zhang1career/tars-motor-ctrl/src/platforms/stm32f030/README.md

# src/platforms/stm32f030 — STM32F030 平台层

已从 TARS 迁移的 Hall 6-step 电机控制：

| 文件 | 职责 |
|---|---|
| `hall6.c/.h` | Hall 闭环 6-step：kick、MOE 延迟释放、FocTheta 插值与一圈 ω |
| `openloop.c/.h` | 6-step / 3-step 开环 + Hall lock/kick/stall（实机诊断用） |
| `motor_pwm.c/.h` | TIM1 六路互补 PWM（20 kHz 中心对齐）、死区、MOE 控制 |
| `motor_hall.c/.h` | Hall GPIO 读取 |
| `motor_tick.c/.h` | 控制环 ISR 分发（hall6 / openloop），跑在 **TIM1 update** 上 |
| `motor_trace.c/.h` | 逐拍采样缓冲（4 ch × 256，2 KB），主机侧 `scripts/trace_dump.py` |
| `motor_adc.c/.h` | PWM 同步的三相电流 + 母线电压采样（TIM1 CH4 → TRGO → ADC → DMA） |
| `motor_angle.c/.h` | Hall 连续电角度（锚点 + per-sector 时长记忆外推） |
| `motor_cycles.c/.h` | 目标板执行时间测量，**TIM16** 自由运行计数器 |
| `motor_foc_fx.c/.h` | 定点 FOC：电流环 + 速度环。成绩见 [`docs/report/speed-loop-20260914.md`](../../../docs/report/speed-loop-20260914.md) |

正式控制方式是 **hall6 闭环**；`openloop.c` 只在实机排查时用（配合
`src/firmware/stm32f030/scripts/` 下的扫描脚本）。

默认应用参数见 `App/motor_app.c`，由实测得出：

```
phase 3, kick duty 20%, run duty 20%, direction 0（顺时针；1 为逆时针）
```

## 控制环时基

`MotorTick_Init()` 不配置 TIM3；控制环由 **TIM1 update 中断**驱动
（`MotorTick_OnTim1Update()`），与 TARS 一致。中心对齐计数在上溢和下溢各产生一次
update，因此 `motor_pwm.c` 里 `RepetitionCounter = 1`，才能得到
`MOTOR_CTRL_ISR_HZ`（20 kHz）而不是它的两倍。

**TIM3 完全空着**，留给转子角度的输入捕获（LQFP-32 上只有 PB4=CH1、PB5=CH2 能接到
`HALL_B`/`HALL_C`）。`motor_cycles.c` 的周期计数器因此用 **TIM16**，
迁移期遗留的 TIM3 中断分发已删除。

## 逐拍观测（motor_trace）

控制环唯一的细粒度观测手段。要点只有两条，都在
[`measurement-validity.md`](../../../docs/measurement-validity.md) 里有完整推导：

1. **读之前缓冲必须静止**（one-shot 自停，或对 wrap 写 `mode=0` 冻结）。
   256 拍只有 12.8 ms，而读出要约 1 s——边读边写会得到几十个片段的拼接。
2. **`ticks_since_edge` 是连贯性判据**：每个 Hall 边沿样本的值必须小于抽取比。
   它同时能把扇区长度精确重建到 50 µs，与抽取率无关。

## 相位状态编码

`motor_phase_mode_t` 三态含义与写入 TIM1 的方式：

| 状态 | CCER | CCR |
|---|---|-----|
| `MOTOR_PHASE_OFF` | 清 `CCxE` 与 `CCxNE` | 0 |
| `MOTOR_PHASE_PWM` | 置 `CCxE` 与 `CCxNE`（互补 + 死区） | 目标脉宽 |
| `MOTOR_PHASE_LOW` | 清 `CCxE`、置 `CCxNE` | **`ARR + 1`** |

`MOTOR_PHASE_LOW` 用 `ARR+1` 而不是 0：`CCxE=0, CCxNE=1` 时 OCxN 引脚直接跟随
OCxREF（不反相、不插死区），`CCR=0` 会让低边恒关、回流臂断开。

## 换向

`hall6_lookup(hall, reverse)` 与 `ol_lookup_step(hall, ccw)` 在反向时把 **PWM 相与
LOW 相互换**——同一转子位置下绕组电流反向，力矩反向而幅值不变，所以正反转效率对称。
仅靠 `direction` 位切换 hall 序列是不够的：`s_seq_ccw` 是 `s_seq_cw` 的反序，等价于
偏移 `−p`，而 `−p ≡ p (mod 6)` 恰好落在 phase 0 和 3 这两个唯一高效的偏移上。其余陷阱见
[`src/firmware/stm32f030/README.md`](../../firmware/stm32f030/README.md#已知陷阱)。

板级管脚见 `src/firmware/stm32f030/board_pins.h`。
