zhang1career/tars-motor-ctrl/docs/mainboard-spec.md

# motor-ctrl 主板设计规格（STM32F030K6 + 三相电流采样前端）

**状态**：原理图之前的**真源**。改电路先改本文，再改 KiCad 工程。

本板取代当前实测接法（MCU 由 nanoDAP 供电 + 裸分流直连 ADC），
目标是解锁 [`roadmap.md`](roadmap.md) 阶段 C（相电流采样）与阶段 E（电流环闭合）。

---

## 0. 依据（实测或数据手册，非估算）

| 项 | 值 | 来源 |
|---|---|---|
| 分流电阻 `R0` | 10 mΩ / 2512 | 半桥板网表 |
| 分流拓扑 | `Q2.S → I_SENSE → R0 → GND`（低边） | 半桥板网表 |
| `J2` 引出 | pin1 = `R0.2`(GND)，pin2 = `R0.1`(I_SENSE) | 半桥板网表 |
| 绕组电阻 | 相间 1.3 Ω → 每相 0.65 Ω | 实测 |
| 绕组电感 | 相间 874.7 µH → 每相 437.3 µH（LCR 1 kHz） | 实测 |
| 极对数 | **4**（10 s 内 311 Hall 边沿 = 51.8 电周期 ÷ 13.5 机械圈） | 实测 |
| 母线 | 12 V，实验电源限流约 1.6 A | 实测 |
| 工作点绕组电流 | 约 1.6 A @ duty 20% | 实测 |
| FOC 浮点耗时 | 15~18 k 周期（377 µs @ 48 MHz） | 阶段 B 实测 |
| UCC27211 VDD | 推荐 8 / 12 / 17 V，绝对最大 20 V | 手册 5.1 / 5.3 |
| UCC27211 `VHB−VHS` | 与 VDD 同为 −0.3 ~ 20 V 绝对最大 | 手册 5.1 |
| UCC27211 HB UVLO | 上升 6.7 V typ（5.6 min / **7.9 max**），滞环 1.1 V | 手册 5.5 |
| UCC27211 自举二极管 | **片内**，阳极 VDD、阴极 HB | 手册 6.3.4 |
| V_BOOST 实测 | **12.6 V**（12 V 经一只二极管） | 用户实测 |

### 0.1 V_BOOST 现状的正确结论

半桥板 `D1`（1N4148, `V_BOOST → HB`）与 UCC27211 **片内自举二极管并联**，
两者阳极都在 12 V 附近：

```
低占空比 (HS≈0V)    : V_C3 ≈ 12.6 − 0.8 = 11.8 V    → 落在 8~17 V 推荐窗口，安全
接近 100% duty      : 12.6 − 0.8 − 12 = −0.2 V      → D1 不导通，该路无贡献
```

**没有过压隐患。** roadmap 早期记录的「外部电荷泵 12 V → 约 20 V」与实测 12.6 V 不符，
应据实测修正；基于「20 V」推出的过压结论不成立。

但**高占空比适应性目前并不存在**——高边仍只靠片内自举，高 duty 下仍会掉进 HB UVLO。

真升压的正确形式（非旁路二极管）：

```
V_BOOST ≈ 24 V  且  HB−HS 加 15 V 齐纳钳位 + D1 后串限流电阻

低占空比   : 齐纳钳在 15 V                    (< 17 V 推荐上限, < 20 V Vgs 上限)
100% duty  : min(24 − 0.8 − 12, 15) = 11.2 V  (远高于 7.9 V 最坏 UVLO)
```

单一固定 V_BOOST 经普通二极管灌 HB **无法同时满足两端**：
`V_C3 = V_BOOST − Vf − V_HS`，而 `V_HS` 在 0 与 12 V 之间摆。
24 V 不加钳位时低占空比会把 C3 充到 23.2 V，**超过 20 V 绝对最大值，损坏驱动器**。

### 0.2 本版为何先不需要升压

低边分流采样需要低边导通窗口：

```
死区 1.5 µs + INA240 建立 ~2 µs + ADC 采样转换 ~1 µs ≈ 5 µs
→ 20 kHz (50 µs) 下 duty 上限约 90%
```

> **实测修正（2026-08-27）**：INA240 + 输出 RC 的建立时间实测**约 2 µs**，与此处假设一致
> （示波器测 `ISENSE_V` 在开关沿后到最终值一个量化码内的时间，见 roadmap 4.1）。
> 但 duty 上限没有 90% 那么高：固件为了让转换在控制 ISR 之前完成，把 ADC 序列**提前 7 µs**
> 启动，而四通道扫描本身要 6.67 µs，所以需要的半窗口是 9 µs 而非 5 µs，**上限约 67%**。
> 把 `MOTOR_ADC_LEAD_COUNTS` 减半可推到约 80%。

**比自举失效点（约 95%）更严。** 只要用低边采样，自举极限到不了。
升压真正开始重要是换成 **inline 相线采样**之后（低边采样在高调制度下失明）。
本板电荷泵输出**直接驱动 `V_BOOST`**（无跳线旁路 12 V），默认不启泵时 `V_BOOST` ≈ 10.6 V。

---

## 1. 电流采样前端

### 1.1 为什么必须差分

三块半桥板各有独立 GND 引线回主板。按 1 nH/mm 估，100 mm 引线约 100 nH；
AOD4184 关断 1.6 A 的电流变化率约 30 A/µs 量级：

```
V = L·di/dt = 100 nH × 3×10⁷ A/s ≈ 伏级瞬态
```

满量程信号仅 `±3 A × 10 mΩ = ±30 mV`。**单端测量在物理上无意义。**
1% 分立电阻搭差分放大器的共模抑制比仅 `1/(4×1%)` ≈ 28 dB，同样不够。
必须用内部修调电阻的电流检测放大器。

### 1.2 器件与工作点

| 项 | 值 | 说明 |
|---|---|---|
| 器件 | **INA240A2D**，增益 50 V/V，SOIC-8 | 内部修调，CMRR 120 dB(DC) / 90 dB(50 kHz) |
| 关键特性 | enhanced PWM rejection | 专为开关电机驱动的共模阶跃设计 |
| 共模范围 | −4 ~ +80 V | `I_SENSE` 续流时低于地；留 inline 升级余量 |
| 供电 | 3.3 V（器件范围 2.7~5.5 V） | 与 ADC 同轨 |
| 带宽 | 400 kHz | 在采样窗口内充分建立 |
| 中轨偏置 | **`REF1`(pin 7) → `GND`，`REF2`(pin 6) → `+3V3A`** | 内部二分得 1.65 V，**比例跟踪 ADC 参考**；接法理由见 §1.2.1 |
| 满量程 | ±2.9 A | `±30 mV × 50 = ±1.5 V`，受输出摆幅(约 0.02~3.1 V)限制 |
| 分辨率 | **1.61 mA/LSB** | `3.3/4096/(50×0.01)`，比裸分流 80.6 mA/LSB 好 **50 倍** |

#### 1.2.1 REF1 / REF2 的分配是布局自由度，不是电气约束

数据表 **SBOS712 §8.4.1** 原文：

> The reference inputs are connected to an internal gain network.
> **There is no operational difference between the two reference pins.**

参考分压精度的定义本身就是对称的（取绝对值）：`VOUT = |(VREF1 − VREF2)| / 2`，
指标 0.02% typ / 0.1% max，**两种接法同一条**。所以中轨 1.65 V、满量程 ±2.9 A、
1.61 mA/LSB、以及 §2 里 `ITRIP_HI/LO` 与本参考同源的比例跟踪，都与分配方向无关。

**采用 `REF1 → GND`、`REF2 → +3V3A`**，两个理由：

1. **TI 自己的应用示例就是这个方向**（§9.2.1.2 的 36 V / 4000 RPM 电机驱动用 INA240A1，
   另一处用 INA240A4），原文：「the reference point is set to midscale by splitting the
   supply with REF1 connected to ground and REF2 connected to supply」。
2. **SOIC (D) 封装上布线更短**：引脚顺序是 `4=GND, 5=VS, 6=REF2, 7=REF1, 8=OUT`，
   `REF2` 与 `VS` **相邻**，这一跳是焊盘到焊盘；`REF1` 只需一个过孔下地平面。
   反过来接则 `VS` 要越过 pin 6 的焊盘去 pin 7，而 `GND` 要挤进 VS 与 REF1 之间。
   附带好处：`VS` 的 100 nF 去耦就在 pin 5，`REF2` 直接共享那个低阻抗点，
   VS 与参考之间不再夹一段走线电感（内部分压会把二者压差的一半搬到输出偏置上）。

唯一的硬约束（数据表 Note，两种接法都满足）：
**不得把 `REF1`/`REF2` 接到低于 `GND` 或高于 `VS` 的电位。**

`check_netlist.py` 按集合判定 `{pin6, pin7} == {GND, +3V3A}`，两种接法都通过 ——
分配方向留给布局。

增益选 A2(50) 而非 A3(100)：工作点绕组电流约 1.6 A，增益 100 在 1.45 A 即削顶。

### 1.3 KiCad 符号必须自建（已完成，勿改回官方库）

**KiCad 10.0.3 自带库的 INA240 符号 D / PW 引脚定义互换**，直接使用会烧件。

| 引脚 | KiCad `INA240A2D`(SOIC 封装) | **TI 手册 D (SOIC)** | KiCad `INA240A2PW`(TSSOP 封装) | TI 手册 PW (TSSOP) |
|---|---|---|---|---|
| 1 | IN− | **NC** | NC/GND | IN− |
| 2 | GND | **IN+** | IN+ | GND |
| 3 | REF2 | **IN−** | IN− | REF2 |
| 4 | GND | **GND** | GND | NC |
| 5 | OUT | **VS** | VS | OUT |
| 6 | VS | **REF2** | REF2 | VS |
| 7 | REF1 | **REF1** | REF1 | REF1 |
| 8 | IN+ | **OUT** | OUT | IN+ |

名为 `…D`（SOIC 封装）的符号带 **TSSOP** 引脚号；名为 `…PW`（TSSOP 封装）的带 **SOIC** 引脚号。
仅 pin 7 (REF1) 碰巧一致。误用会把 3.3 V 灌到 OUT、把输出接到 VS —— **上电即毁**。

→ 已建项目本地库 **`pcb/lib/motor-ctrl.kicad_sym`**，符号名 **`INA240A2D_Fixed`**，
按 TI Table 6-1 (D 封装) 定义，已用脚本逐脚校验并通过 `kicad-cli sym upgrade` 解析。

### 1.4 每通道外围

```
J_ISx.1 (shunt 低端 = 半桥 GND) ──10Ω──┬── INA240.IN−  (pin 3)
                                       1nF (差分)
J_ISx.2 (shunt 高端 = I_SENSE)  ──10Ω──┴── INA240.IN+  (pin 2)

INA240.OUT (pin 8) ──100Ω──┬── MCU PA1/PA2/PA3
                          1nF → AGND        (fc ≈ 1.6 MHz)
```

- 输入串阻 **10 Ω 且必须匹配**：INA240 输入偏置电流经串阻产生增益误差，阻值要小。
- 差分 1 nF 仅限边沿速率，不做主滤波（主滤波靠**同步采样**，不靠 RC，避免引入延迟）。
- 输出 RC 供 ADC 采样保持电容充电，1.6 MHz corner 不引入可观延迟。
- 每片 INA240 就近 100 nF 去耦；每组 10 µF 体电容。

---

## 2. 过流保护（半桥板无 nFAULT，必须自建）

半桥板 `J3` 仅 4 线：`PWM_LIN` / `PWM_HIN` / `GND` / `V_BOOST`。
UCC27211 本身无故障输出引脚。因此 `board_pins.h` 中

```c
#define BOARD_PWM_BKIN_PIN  GPIO_PIN_6  /* PA6 TIM1_BKIN — nFAULT */
```

是 **TARS 遗留定义，物理上无处可接**。这解释了历史上启用 BKIN 导致 MOE 锁死（引脚悬空）。

STM32F030 **无片内比较器**（F031/F051 才有），故用外部窗口比较器：

```
每相 2 个比较器（正向 / 反向越限）× 3 相 = 6 个 → 2 × LM339（8 路，剩 2 路做过温，见 §6.2）
6 路开集输出线或 → nFAULT → JP2 → PA6 (TIM1_BKIN)，R16 4.7 kΩ 上拉至 +3V3
过温 2 路线或到独立的 nOTEMP → D5 单向注入 nFAULT，并直连 PA12（§6.2）
```

阈值（±2.5 A 跳闸）：`1.65 ± 2.5 × 0.01 × 50 = 1.65 ± 1.25 V` → **0.40 V / 2.90 V**。

比较逻辑（LM339 开集输出在 `V+ < V−` 时拉低）：

| 功能 | `+` 输入 | `−` 输入 | 拉低条件 |
|---|---|---|---|
| 正向越限 | `ITRIP_HI` (2.90 V) | `IOUT_x` | `IOUT_x > 2.90 V`，即电流 > +2.5 A |
| 反向越限 | `IOUT_x` | `ITRIP_LO` (0.40 V) | `IOUT_x < 0.40 V`，即电流 < −2.5 A |
| 过温 2 路 | `OTEMP1` / `OTEMP2` | `ITRIP_LO` (0.40 V) | `OTEMPn < 0.40 V`，即远端 NTC 过热（§6.2） |

**8 路全部有实际功能，没有置死单元。** 过温那两路输出接 `nOTEMP` 而非 `nFAULT`，
理由见 §6.2 —— `nFAULT` 是线或，无法区分故障源。

### 2.1 LM339 必须用 12 V 供电（不能用 3.3 V）

LM339 是 Darlington 输入级，**输入共模上限只到 `VCC − 1.5 V`**
（TI 应用手册 SNOAA35 明确建议全温区按 `VCC − 2 V` 设计）：

| 供电 | 推荐共模上限 | 能否容纳 2.90 V 阈值 |
|---|---|---|
| 3.3 V | 1.3 V | **否** |
| 5 V | 3.0 V | 勉强，无余量 |
| **12 V** | **10 V** | **可以，余量充足** |

`LMV339`（低压版）在 3.3 V 下共模上限同样不够，也不能用。
因此 **LM339 的 `V+` 接 `+12V`、`V−` 接 `GND`**；输入信号 0.15~3.15 V 落在共模范围中部，
开集输出上拉到 `+3V3`，MCU 引脚电平安全。这是开集输出的天然好处——供电轨与逻辑电平可以分开。

阈值分压串（从 `+3V3A` 取，与 INA240 的 REF **同源以保持比例跟踪**）：

```
+3V3A ──[R 4.02k]── ITRIP_HI ──[R 24.9k]── ITRIP_LO ──[R 4.02k]── GND     (1%, E96)

ITRIP_HI = 3.3 × (4.02+24.9)/32.94 = 2.897 V      分压串电流约 100 µA
ITRIP_LO = 3.3 ×  4.02/32.94       = 0.403 V
```

两个阈值节点各加 100 nF 对地去耦。LM339 输入偏置电流约 25 nA，
在 33 kΩ 分压阻抗上仅产生约 0.8 mV 误差，可忽略。

`JP2` 可断开，避免重复历史上 MOE 锁死的坑（见 §0 与 roadmap 待决项 #4）。

---

## 3. 引脚分配（与 `board_pins.h` 严格一致）

STM32F030K6Tx，LQFP-32，符号 `MCU_ST_STM32F0:STM32F030K6Tx`，
封装 `Package_QFP:LQFP-32_7x7mm_P0.8mm`。引脚表已与官方符号逐脚核对。

| 引脚 | 名称 | 网络 | 用途 |
|---|---|---|---|
| 1 | VDD | `+3V3` | 数字供电 |
| 2 | PF0 | `OSC_IN` | 8 MHz 晶振 |
| 3 | PF1 | `OSC_OUT` | 8 MHz 晶振 |
| 4 | NRST | `NRST` | SWD 复位 |
| 5 | VDDA | `+3V3A` | 模拟供电（经磁珠隔离） |
| 6 | PA0 | `NTC` | ADC_IN0，板温 |
| 7 | PA1 | `ISENSE_U` | ADC_IN1 ← INA240_U.OUT |
| 8 | PA2 | `ISENSE_V` | ADC_IN2 ← INA240_V.OUT |
| 9 | PA3 | `ISENSE_W` | ADC_IN3 ← INA240_W.OUT |
| 10 | PA4 | `VSENSE_12V` | 母线电压分压 → ADC（§9.5.1） |
| 11 | PA5 | `VSENSE_V_BOOST` | V_BOOST 监测 → ADC（§9.5.2） |
| 12 | PA6 | `nFAULT_MCU` | TIM1_BKIN ← 窗口比较器（经 `JP2` / `BKIN_EN`） |
| 13 | PA7 | `PWM_U_L` | TIM1_CH1N → 半桥1 `J3.1` (LI) |
| 14 | PB0 | `PWM_V_L` | TIM1_CH2N → 半桥2 `J3.1` (LI) |
| 15 | PB1 | `PWM_W_L` | TIM1_CH3N → 半桥3 `J3.1` (LI) |
| 16 | VSS | `GND` | |
| 17 | VDD | `+3V3` | |
| 18 | PA8 | `PWM_U_H` | TIM1_CH1 → 半桥1 `J3.2` (HI) |
| 19 | PA9 | `PWM_V_H` | TIM1_CH2 → 半桥2 `J3.2` (HI) |
| 20 | PA10 | `PWM_W_H` | TIM1_CH3 → 半桥3 `J3.2` (HI) |
| 21 | PA11 | `CP_DRIVE` | TIM1_CH4 → 电荷泵驱动（预留）+ 测试点 |
| 22 | PA12 | `nOTEMP` | 过温故障输入（EXTI12，区分过温/过流，§6.2）；`TP5`。AF `TIM1_ETR` 仍可用（开集弱上拉） |
| 23 | PA13 | `SWDIO_MCU` | 经 `R36` 100 Ω → `IR_OUT`（§9.6.3）；AF0 仍可 SWDIO |
| 24 | PA14 | `SWCLK_MCU` | 经 `R35` 100 Ω → `SWCLK`（§9.6.3）；AF1 = USART1_TX |
| 25 | PA15 | `TP_CYCLE` | GPIO 示波器时标（`motor_cycles.c`，`TP1`）；经 `R37` 100 Ω → `USART1_RX` → `J12.3`（与时标互斥）。**EVENTOUT 不使用** |
| 26 | PB3 | `HALL_A` | 黄 Ha（GPIO；无 TIM3） |
| 27 | PB4 | `HALL_B` | 绿 Hb（**TIM3_CH1** 可用于边沿捕获） |
| 28 | PB5 | `HALL_C` | 蓝 Hc（**TIM3_CH2** 可用于边沿捕获） |
| 29 | PB6 | `I2C_SCL` | I2C1 / TNB |
| 30 | PB7 | `I2C_SDA` | I2C1 / TNB |
| 31 | BOOT0 | `BOOT0` | 默认 `R17` 10 kΩ 下拉；`JP3` 可拉高进 bootloader |
| 32 | VSS | `GND` | |

### 3.1 ADC 触发源：不占引脚

F030 可用 ADC 外部触发（HAL 头文件实测）：

```
ADC1_2_EXTERNALTRIG_T1_TRGO / T1_CC4 / T2_TRGO / T3_TRGO / T15_TRGO
TIM1 MMS: TIM_TRGO_UPDATE / TIM_TRGO_OC1REF … TIM_TRGO_OC4REF
```

**采用 `TIM1_TRGO` ← update 事件。** 中心对齐 + `RCR=1` 时每 PWM 周期一次，
落在计数器峰值 —— 正是低边导通窗口中心。全程内部信号，**不占用 PA11**。

> roadmap 待决项 #2 需修正：CC4 作为 ADC 触发是**内部事件**，
> 只有 CH4 的**引脚输出**才与电荷泵抢 PA11；但 CCR4 会被电荷泵占用，
> 故改用 TRGO/update 完全避开，两边都不牺牲。

> **TIM3 与 Hall**：F030 LQFP-32 上 TIM3 只有 **PB4=CH1**、**PB5=CH2** 可用（CH3/CH4 与 PWM 低侧冲突）。
> 因此 **HALL_B→PB4、HALL_C→PB5** 可硬件捕获，**HALL_A→PB3** 仅 GPIO/EXTI；
> 三路可共用 TIM3 时基，B 通道在边沿中断里锁存 `TIM3->CNT` 即可。
>
> **TIM3 冲突提醒**：`motor_cycles.c`（阶段 A2）把 TIM3 用作 48 MHz 自由运行周期计数器。
> 若启用 Hall 捕获，须统一 TIM3 用途（同一时基 + 输入捕获，或改 cycle bench 用别的定时器）。

---

## 4. 供电

```
J1 ─[F1 2A 自恢复]─┬─[D7 SMBJ14A]─ GND        (输入保护，见 §4.1)
                   └─[D6 SS34]─→ +12V
+12V ─┬─ AMS1117-3.3 (SOT-223) → +3V3 ─┬─ 数字 (VDD)
     │                       │                                └─ 磁珠 → +3V3A (VDDA, INA240 VS, REF)
     ├─ J21（螺钉端子，三块半桥板的功率供电，与 J1 并联）
     ├─ 3 × J_CTRL.4 (V_BOOST)
     └─ 电荷泵升压级（PA11 驱动, 目标 ≈22 V）→ 直出 V_BOOST
```

### 4.1 输入保护（`F1` / `D6` / `D7`）

**关键约束：`J21` 给三块半桥板供电，母线电流全部经 `F1` 和 `D6`。**
所以这两个器件按「板上过流阈值允许的母线电流」定额，而不是按逻辑电流：

| 参考点 | 母线电流 | 来源 |
|---|---|---|
| 空载 | 0.05~0.07 A | roadmap 1.2 实测 |
| duty 20% 工作点 | 0.26 A | roadmap 3.3 实测 |
| 当前电源限流 | 1.6 A | roadmap 0.5（阶段 F 前须提高） |
| **`ITRIP` 阈值允许的上限** | **约 2.2~2.5 A** | §2 阈值 ±2.5 A/相，高占空比下母线≈相电流 |

| 器件 | 值 | 说明 |
|---|---|---|
| `F1` | 2 A 自恢复保险丝（PPTC，1206） | 标称值是**保持电流**；跳闸约 2× 保持、秒级动作。60 °C 环温降额后有效约 1.4 A。**它保护线缆与电源，挡不住瞬时短路** |
| `D6` | **SS34**（3 A / 40 V，SMA） | 串联反接保护。1 A 的 SS14 会成为链上最弱环——`F1` 要到约 4 A 才动作，永远保护不了它 |
| `D7` | **SMBJ14A**（600 W，SMB），接在 `F1` 与 `D6` **之间** | 截止 14 V / 击穿 15.6~17.2 V / 钳位 23.2 V |

**`D7` 的位置是有意的**（不在 `+12V` 上）：`F1` 在它上游 → 持续过压时保险跳闸而不是 TVS 烧毁；
它在 `D6` 上游 → 浪涌电流不必穿过 `D6`；反接时单向 TVS 正向导通 → 帮助拉跳 `F1`。

**必须认清 TVS 的能力边界**：12 V 轨的 TVS 钳位必然在 23 V 以上，而 `AMS1117` 输入绝对最大值
**15 V**、经 `J21` 供到半桥板的 `UCC27211` VDD 绝对最大值 **20 V**。所以它只吸收
**快速大能量瞬态**（带载拔电源时电机电感反冲、热插拔），**挡不住持续过压**——误插 24 V 电源
照样烧 LDO，这条链里没有器件能防。

**串联压降的代价**：`SS34` 在 1.6 A 下约 0.4 V、2.5 A 下约 0.45 V（约 1.1 W），
直接从 12 V 母线里扣掉，也让 roadmap 0.5 的电源塌陷更严重。**`D6` 需要敷铜散热**（见 §7）。
若将来母线电流超过约 2.5 A，正确升级是 **P 沟道 MOSFET 理想二极管**（2 A × 30 mΩ = 0.06 V）。

`VSENSE_12V`（`R30`）取样在 `D6` **之后**，所以固件量到的是真实的二极管后母线，
FOC 的 `vdc` 不需要补偿；电荷泵的 `D2` 同样从二极管后取电，`V_BOOST` 因此比理想值低约 0.4 V。

**母线储能 30 µF**（`C1`/`C35`/`C37` 各 10 µF，外加 `C25`/`C26`/`C27`/`C36` 各 100 nF）。
2 A 的 20 kHz 斩波下 `ΔV = I·t/C = 1 A × 25 µs / 30 µF ≈ 0.8 V` 峰峰。
**这个交流分量必须由板上电容就近吸收**——否则它会经 `F1`/`D6`/杜邦线来回跑，
把 PPTC 的热效电流抬到直流均值之上、更易误跳。`C37` 就是为此补的第三只 10 µF。
半桥板侧仍应有自己的 VIN 体电容，见 roadmap 0.5「储能加在 VIN」。

**采用单级 LDO，不用开关电源。** 负载估算：
MCU 约 15 mA + 3 × INA240 各 2.4 mA + 3 × Hall 约 10 mA + 杂项 ≈ 60~70 mA，设计上限取 100 mA。

| 方案 | 12V→3.3V @100 mA 耗散 | 噪声 | 结论 |
|---|---|---|---|
| **单 LDO (SOT-223)** | 0.61 W @70 mA / 0.87 W @100 mA；SOT-223 约 60 °C/W → 升温约 37~52 °C | **无开关噪声** | **采用** |
| buck 5V + LDO 3.3V | LDO 仅 0.17 W | 开关节点靠近 30 mV 模拟信号 | 负载这么小时不值得 |
| 单 buck 直出 3.3V | 最低 | 开关噪声直接进模拟轨 | 否 |

在 70 mA 这个量级，LDO 的热损耗完全可以接受（SOT-223 配敷铜，结温约 62~77 °C），
而**彻底没有开关节点**对 ±30 mV 的分流信号是实打实的好处。
`AMS1117-3.3` 输入上限 15 V，12 V 输入有余量。LDO 布局上远离三片 INA240。

若将来负载显著增加（加显示、更多传感器）再改两级，本板不预留 buck 位置。

**板载 3.3 V 取代 nanoDAP 供电**：roadmap 已把「探头供电」列为误判来源
（探头掉线表现为「母线 0.000 A 且完全无 PWM」，极易误判成硬件坏）。

---

## 5. 连接器（与半桥板一一对应，便于普通杜邦线）

| 编号 | 型式 | 引脚 | 对接 |
|---|---|---|---|
| `J_CTRL1..3` | 1x04 P2.54 | 1=`PWM_x_L`, 2=`PWM_x_H`, 3=`GND`, 4=`V_BOOST` | 半桥板 `J3` |
| `J_IS1..3` | 1x02 P2.54 | 1=shunt 低端, 2=shunt 高端 | 半桥板 `J2` |
| `J_HALL` | 1x05 P2.54 | **1=`GND`, 2=`+3V3`**, 3=`HALL_A`, 4=`HALL_B`, 5=`HALL_C` | 电机 Hall（`J8`） |
| `J_DEBUG` | 1x05 P2.54 | `GND`, `IR_OUT`, `SWCLK`, `+3V3`, `NRST` | 调试/红外（`J9`；无 SWDIO 引出） |
| `J_IR` | 1x02 P2.54 | `GND`, `IR_OUT` | 红外输出（`J11`） |
| `J_UART` | 1x03 P2.54 插座 | `GND`, `SWCLK`(=PA14 TX), `USART1_RX`(=PA15) | USB-TTL / bootloader（`J12`，兼作 SWCLK 探针） |
| `J14` / `J15` | 1x02 P2.54 | `OTEMP1` / `OTEMP2`, `GND` | 外接 10 kΩ NTC（§6.2） |
| `J_I2C` | 1x04 P2.54 | `+3V3`, `SDA`, `SCL`, `GND` | 主机 / TNB |
| `J_PWR` | 螺钉端子 1x02 | `12V`, `GND` | 实验电源（`J1`，经 `F1`/`D6` 进板，§4.1） |
| `J21` | 螺钉端子 1x02（Phoenix MKDS-1,5-2-5.08） | 1=`GND`, 2=`+12V` | **三块半桥板的功率供电**，与 `J1` 并联（§5.1） |

**所有排针的 pin 1 都是 `GND`**（`J1`/`J8`/`J9`/`J10`/`J11`/`J12`/`J21`），保持这个约定。

### 5.1 `J21`：三块半桥板共用一个功率端子

用螺钉端子而不是 2.54 mm 针座：`ITRIP` 阈值允许的母线电流约 2.5 A，超出针座的合理范围；
Phoenix MKDS-1,5 按 1.5 mm² 端子额定约 13.5 A，余量充足。三块半桥板在**板外并接**到这一个端子。

两个由此产生的注意点：

1. **三块板的功率地在板外汇合**，不再各自有独立回流脚。这对分流采样无影响——
   INA240 是差分测量（§1.1），板间共模差由它的 120 dB / 90 dB@50 kHz 抑制掉。
   但共用回流线上跑的是三相斩波电流的**和**，稳态基波相互抵消而开关分量不抵消，
   所以这根线要短、要粗，最好与 `+12V` 那根**紧贴走**以减小回路面积。
2. **`H1`/`H2`/`H3` 是接地的 M3 安装孔**（`MountingHole_Pad`，焊盘接 `GND`）。
   若机箱另有接地点，注意不要形成大面积地环。

**`J_IS1..3` 的两根线在 PCB 上与电缆里都必须作为紧耦合差分对处理**——
共模是主误差源（见 1.1）。电缆建议双绞。

**Hall 供电为 `+3V3`，不设跳线。** `board_pins.h` 标注 3.3 V，且实测已证实
（hall6 闭环正常换相，10 s 读到 311 个 Hall 边沿），因此无需保留 5 V 选项与选择跳线。
Hall 信号线上拉同样接 `+3V3`（见 §6），保证 MCU 输入不超过 3.3 V。

---

## 6. 其余外围

| 项 | 值 | 说明 |
|---|---|---|
| 晶振 | 8 MHz 两引脚 + 2 × 10 pF 负载电容 + `R29` 1 kΩ 串阻 | `main.c` 强制 HSE，失败即 `Error_Handler()`。**必装** |
| Hall 上拉 | 4.7 kΩ → **`+3V3`**，串 1 kΩ + 1 nF 对地 | 开集输出需上拉；`fc ≈ 160 kHz` |
| BOOT0 | `R1` 10 kΩ 下拉 + `JP3`（`+3V3`↔`BOOT0`） | 见 §9.6.2；探测点用 `JP3` pin 2 |
| NRST | 100 nF 对地 + **10 kΩ 上拉**（`R23`） | connect-under-reset |
| SWCLK | **100 Ω 串阻**（`R35`：`U1.24` ↔ `SWCLK`，靠近 MCU） | PA14/UART TX 与调试器对顶（§9.6.3） |
| IR 输出 | **100 Ω 串阻**（`R36`：`U1.23` ↔ `IR_OUT`，靠近 MCU） | PA13 红外推挽与探头对顶（§9.6.3） |
| I2C | **10 kΩ 上拉**（`R26`/`R27` → `+3V3`） | TNB 主机 |
| 指示 | `D1`+`R24`（12 V 电源）、`D4`+`R34`（3.3 V 状态） | 目视确认上电 |
| 去耦 | 每 VDD 100 nF；VDDA 1 µF + 100 nF | |
| NTC | 10 kΩ NTC + 10 kΩ 分压 + `C33` 100 nF → PA0 | 板温遥测；功率级过温靠 §6.2 |
| I2C ESD | `D8` PRTR5V0U2X（1=GND, 2=SDA, 3=SCL, 4=`+3V3`） | 1 pF/线，相对 400 pF 总线预算可忽略 |
| +3V3 ESD | `D9` SMAJ5.0A | **仅 ESD**：钳位 9.2 V 远高于 STM32 的 4.0 V 绝对最大值 |

Hall 边沿率上限核算：3000 rpm 机械 = 50 机械转/s × **4 极对** × 6 边沿 = **1.2 kHz**，
160 kHz 滤波余量充足。

### 6.1 调试测试点（`TP1`…`TP23`，无 `TP10`）

手工原理图在关键节点加了测试点，便于 bench 探针而无需飞线 MCU 引脚。

| 编号 | 网络 | 用途 |
|---|---|---|
| `TP1` | `TP_CYCLE` | PA15 示波器时标 / bootloader RX |
| `TP2` | `CP_DRIVE` | PA11 电荷泵驱动 |
| `TP3` | `VSENSE_12V` | PA4 母线分压 |
| `TP4` | `VSENSE_V_BOOST` | PA5 V_BOOST 分压 |
| `TP5` | `nOTEMP` | PA12 过温故障线（§6.2） |
| `TP6` | 电荷泵推挽基极 | Q1/Q2/Q3 基极节点 |
| `TP7` | 电荷泵开关节点 | `CP_SW`（Q1.E / Q2.E） |
| `TP9` | 电荷泵泵电容节点 | D2/D3/C32 交汇 |
| `TP11`…`TP13` | `ISENSE_U/V/W` | INA240 输出经 RC 后 → MCU ADC |
| `TP14`…`TP16` | `IOUT_U/V/W` | INA240 原始输出（比较器输入） |
| `TP17` / `TP18` | `ITRIP_HI` / `ITRIP_LO` | 过流阈值 |
| `TP19` | `nFAULT_MCU` | BKIN 路径（经 `JP2`） |
| `TP20` | `NTC` | 板温分压 |
| `TP21`…`TP23` | `HALL_A/B/C` | Hall 滤波后 MCU 输入 |
| `TP24` / `TP25` | `OTEMP1` / `OTEMP2` | 远端 NTC 分压节点，用于判断是哪一路过热 |

晶振走线：`Y1` 为两引脚 HC-18；`C1` 接 `OSC_IN`，`C2` 接晶振对端并经 `R29` 1 kΩ 至 `OSC_OUT`。

### 6.2 远端 NTC 过温保护（LM339 余下 2 路）

板载 `RT1`（PA0）量的是**主板温度**，主要被 LDO 那 0.6~0.9 W 主导，**看不到半桥板 MOSFET 与电机**——
而 roadmap 记录的过热事故正是「3 号板过热」，阶段 G 还有永磁体不可逆去磁风险。
ADC 通道已用尽（MCU 自带 die 温度与 VREFINT 只覆盖板级），**比较器不需要 ADC 通道**，正好补这个盲区。

```
+3V3A ──[R38 10k]──┬── OTEMP1 ──┬── J14.1   (J14.2 = GND，外接 10k NTC)
                   │            ├──[C30 100nF]── GND
                   │            ├──[R39 100k]── nOTEMP      (迟滞)
                   │            └── U7C.11 (+)
U7C: − = ITRIP_LO   out = nOTEMP          (OTEMP2 / R41 / C31 / R42 / U7D 同构)

+3V3A ──[R40 4.7k]── nOTEMP ──┬── U1.22 (PA12, EXTI12) + TP5
                              └── D5 (BAT54) K ── A ── nFAULT
```

**门限白蹭现成的 `ITRIP_LO`。** 分压方向是「上拉 + NTC 对地」，温度升高 → 节点电压**下降**；
分压串与 `ITRIP_HI/LO` 同取自 `+3V3A`，保持比例跟踪。

**选用 NTC：10 kΩ @25 °C，B = 3435。**
**两路门限不同** —— 每路有自己的上拉与迟滞电阻，只有阈值节点 `ITRIP_LO` 共享，
所以上拉阻值就是该路的门限旋钮：

| 通道 | 探头位置 | 上拉 / 迟滞 | 跳闸 | 恢复 | 迟滞 | 依据 |
|---|---|---|---|---|---|---|
| `OTEMP1` | **半桥板 MOSFET** | `R38` 10 k / `R39` 100 k | **90 °C** | 86 °C | 3.9 °C | AOD4184 `Tj,max` 150 °C，余量充足 |
| `OTEMP2` | **电机磁钢 / 绕组** | `R41` 13 k / `R42` 150 k | **80 °C** | 77 °C | 3.2 °C | N35 类烧结钕铁硼工作上限约 80 °C，见 roadmap 阶段 G 去磁风险 |

（跳闸门限对应的 NTC 阻值：`OTEMP1` 1.26 kΩ、`OTEMP2` 1.66 kΩ；恢复门限 1.40 / 1.82 kΩ。）

门限数字用单 B 值模型算，在 90 °C 处与厂家 R–T 表可能差 2~3 °C；叠加 NTC 与电阻的
1% 容差，实际按 **±5 °C** 看待，需要精确值时以厂家 R–T 表复核。

**`D5` 必须是肖特基，且方向是「A 在 `nFAULT`、K 在 `nOTEMP`」**，这样耦合是单向的：

| 事件 | `nOTEMP` | `nFAULT` | PA12 | 结果 |
|---|---|---|---|---|
| 过温 | U7C/D 拉低 | 经 `D5` 钳低 | **低** | BKIN 跳闸 + 固件知道是过温 |
| 过流 | 高（`D5` 反偏） | U6/U7 拉低 | **高** | BKIN 跳闸 + 固件知道**不是**过温 |

若用硅二极管，过温时 `nFAULT` 低电平 = `V_OL(LM339 最坏 400 mV) + Vf(0.55 V) ≈ 0.95 V`，
逼近 `V_IL ≈ 0.3·VDD ≈ 0.99 V`；BAT54 的 `Vf ≤ 0.32 V` 给出约 0.72 V，余量 270 mV。

三条必须记住的性质：

1. **迟滞电阻只能接 `nOTEMP`，绝不能接 `nFAULT`** —— 否则任一路过流都会去搬动过温门限。
2. **两路迟滞共用 `nOTEMP`**，所以 2 号探头跳闸会把 `OTEMP1` 也拽低约 40 mV（≈3 °C）。
   因为两路本来汇成同一个标志、BKIN 又是锁存的，这个交叉耦合无实际后果。
3. **`J14`/`J15` 空置时 `OTEMPn` = 3.3 V = 不跳闸**。失效方向是「不误跳」，
   探头脱落不会被察觉；这是有意的取舍。
4. 过温这一路的「停用开关」就是**把 NTC 拔掉**，所以不需要跳线；整条 `nFAULT → PA6`
   仍可由 `JP2` 断开。

---

## 7. 布局要点（PCB 阶段验收项）

1. **分流 Kelvin 对**：`J_ISx` 两脚到 INA240 输入走紧耦合差分对、等长，
   中间不跨地平面分割，远离 PWM 走线与功率回流路径。
2. **地分区**：`AGND`（INA240 + VDDA + REF 分压）与 `GND`（数字 + 连接器）
   单点连接，连接点置于 MCU VSS/VDDA 附近。
3. **LDO 及其散热敷铜**远离三片 INA240（0.61 W 的热源，避免热梯度）。
   **`D6` 同样需要敷铜**（2.5 A 下约 1.1 W），并与模拟区分开。
4. **PWM 六路**尽量等长、同臂 H/L 相邻成对，远离模拟区。
5. INA240 去耦电容紧贴 VS 引脚。
6. 电荷泵升压级（预留）与模拟区物理分离。

---

## 8. 与固件的耦合点

| 固件位置 | 依赖本规格 |
|---|---|
| `board_pins.h` | 引脚表须与 §3 一致；`BOARD_PWM_BKIN_PIN` 注释需从「nFAULT」改为「窗口比较器」 |
| `motor_cycles.c` | 用 `BOARD_TP_CYCLE_PIN` = PA15（网表名 `TP_CYCLE`）做示波器交叉验证 → `TP1`。**不使用 EVENTOUT AF**，纯 GPIO 推挽 |
| 阶段 C ADC | 触发源 `TIM1_TRGO` ← update（§3.1）；采样窗口在低边导通期（§0.2） |
| 阶段 C 标定 | 零电流上电校准（INA240 输出应为 1.65 V）；交叉验证用 `I_bus = D_eff²·V/R` |
| 阶段 E 保护 | `JP2` 接通后才启用 TIM1 BKIN；PA12 (`nOTEMP`) 配成 EXTI12 输入以区分过温/过流（§6.2） |

---

## 9. 待确认

| # | 项 | 影响 | 状态 |
|---|---|---|---|
| 1 | 12.6 V 测于二极管**前**还是**后** | 仅影响 §0.1 记录的余量数字，不影响电路 | 未确认 |
| 2 | 电机 Hall 供电 3.3 V 或 5 V | 实测已证实 3.3 V 可用，取消 5 V 选项与跳线（§5） | **已解决** |
| 3 | 是否装配 12 V→24 V 升压级 | 决定升压级是装配还是仅留位置；见 §0.2 | 默认仅留位置 |

**板载 3-BJT 电荷泵**（§9.5.3）。输出直接接到 `V_BOOST` → 三块半桥 `J_CTRL.4`。
**不设 `JP1` 切换**——启泵前须在半桥板加 HB–HS 钳位（§9.5.4），否则低占空比会过压。

---

## 9.5 板载检测与电荷泵

**以 KiCad 手工原理图 `motor-ctrl-mainboard.kicad_sch` 为布局真源**；
`gen_schematic.py` 维护同等网表（标签化、可机器校验），二者须同步。
`add_sense_and_pump.py` 已废弃（TC4427 旧方案）。

### 9.5.1 PA4 母线电压检测（必需，此前是缺口）

`foc_step_stm32(ia, ib, ic, **vdc**, ...)` 把母线电压当**必需输入**，
而原设计没有任何测量手段。FOC 用 `vdc` 归一化 SVPWM 占空比，
写死 12 V 会在电源塌陷（撞 1.6 A 限流）时让输出占空比成比例出错。

```
+24V ──[R30 82k]──┬── VSENSE_24V (PA4)
                  ├──[R31 10k]── GND
                  └──[C28 100nF]── GND
```

分压比 9.2：24 V → 2.609 V，满量程约 30 V，分压串耗流约 235 µA。
固件侧网络名仍对应 ADC 通道 `ADC_IN4`。

### 9.5.2 PA5 V_BOOST 监测

```
V_BOOST ──[R32 18k]──┬── VSENSE_V_BOOST (PA5)
                     ├──[R33 1k]── GND
                     └──[C29 100nF]── GND
```

分压比 19：32 V → 1.684 V，满量程约 62.7 V。电荷泵闭环目标 **32 V**（§9.5.5）。
固件侧对应 `ADC_IN5`。作用是让固件能**直接看到自举/电荷泵塌陷**，
而不是靠电机停转反推——正是 §0.1 讨论的那个高占空比失效模式。

### 9.5.3 板载电荷泵（3-BJT + PA11，无 555 / 无 TC4427）

沿用 `charge-pump/pcb` 的**二极管倍压 + 互补推挽**（`Q1`/`Q2`），振荡源改为 `PA11 = TIM1_CH4`。
PA11 **不能直接驱动** `Q1`/`Q2` 基极（ngspice：3.3 V 直驱 `CP_SW` 仅 2.21 V 峰峰值，
`V_BOOST` 停在 12.2 V 完全不倍压）。

增加 **`Q3` 电平移位 + `R28` 上拉**（`reports/cp_bjt_compare.cir` 方案 D）：

```
PA11 ──[R25 2.2k]── Q3.B ── Q3.E=GND ── Q3.C=CP_BASE ──[R28 470R]── +12V
CP_BASE ── Q1.B / Q2.B ；  Q1(NPN) C=+12V ；  Q2(PNP) C=GND ；  Q1.E=Q2.E=CP_SW
CP_SW ──[C32 47nF]── CP_PUMP ── D2(+12V充电) / D3(→V_BOOST)
V_BOOST ── C34 100nF ∥ C38 10uF ── GND ；  +12V ── C35/C36 去耦
```

| 器件 | 值 |
|---|---|
| `R25` | 2.2 kΩ（PA11 → Q3 基极） |
| `R28` | 470 Ω（+12V 上拉）——**非关键值，220 Ω~2.2 kΩ 等效，见下** |
| `C32` | **470 nF / 0805** ——决定输出阻抗的唯一参数，见下 |
| `R43`/`R44` | 0 Ω，Q1/Q2 各一只独立 base stopper（见下） |
| `Q1`/`Q3` | SS8050；`Q2` SS8550 |

输出**直接驱动 `V_BOOST`**（无 `JP1`、无 TC4427）。停泵时 `V_BOOST` ≈ 10.6 V。
**`Q1`/`Q2` 是互补射极跟随器**（B 经各自 stopper 接 `CP_BASE`、E 共接 `CP_SW`），不是图腾柱：
`V_BE(Q1) = CP_BASE − CP_SW` 与 `V_BE(Q2)` 恒为等值反号，结构上排除直通，
所以 `CP_BASE` 到两管基极**不需要串限流电阻**（`R28` 本身就是上升沿的限流元件）。

`R43`/`R44` 是防**射极跟随器带容性负载寄生振荡**的 base stopper，装 0 Ω；
若实测 `CP_SW` 有高频振铃再换约 22 Ω。**必须每管一只独立**——
在公共节点串一只不是 stopper，只是把 `R28` 变大。

**与 TC4427 取舍：** 选 3-BJT 因成本。固件用 PA11 PWM + PA5 监测闭环调节。

#### 电荷泵实测（ngspice，`reports/cp_r28_sweep.cir` / `cp_load_sweep.cir` / `cp_c32_sweep.cir`）

> 早期 `cp_bjt_compare.cir` 把 `Q1`/`Q2` 的 `nb`/`ne` 写反（ngspice 是 `Q nc nb ne`），
> 导致 `CP_SW` 多数时段悬空；且 10 µF 储能配 47 kΩ 是 470 ms 时间常数，15 ms 根本没到稳态。
> 两处都已修正，下表是修正后的结果。**旧结论「470 Ω 上拉使 `CP_SW` ≈ 11.6 V p-p」作废。**

`R28` 扫描（负载 1 mA）——**摆幅与输出电压几乎不随 `R28` 变化**，只影响峰值电流：

| `R28` | `CP_SW` p-p | `V_BOOST` | `C32` 峰值电流 |
|---|---|---|---|
| 220 Ω | 10.78 V | 20.63 V | 94 mA |
| **470 Ω（现值）** | 10.82 V | 20.68 V | 65 mA |
| 1 kΩ | 10.82 V | 20.71 V | 44 mA |
| 2.2 kΩ | 10.80 V | 20.72 V | 28 mA |

**倍压器的输出阻抗 ≈ `1/(C32·f)` = `1/(47n × 20k)` = 1.05 kΩ**，这才是决定性参数：

| 负载 | `V_BOOST` | 纹波 |
|---|---|---|
| 0.1 mA（近空载） | **21.67 V** | 11 mV |
| 1 mA | 20.68 V | 44 mV |
| 3 mA | 18.78 V | 148 mV |
| 10 mA | **11.32 V**（完全塌陷，不再倍压） | 488 mV |

`C32` 扫描（负载 3 mA）——加大 `C32` 同时改善输出电压**并降低**峰值电流
（同样的每周期电荷量摊在更大的电容上，`ΔV` 更小、导通窗口更长）：

| `C32` | `V_BOOST` @3 mA | 峰值电流 |
|---|---|---|
| 47 nF（原值） | 18.78 V | 232 mA |
| 100 nF | 20.12 V | 140 mA |
| **220 nF** | **20.81 V** | **70 mA** |
| 470 nF | 21.06 V | 35 mA |

→ **已采用 470 nF / 0805**（选 50 V 以限制直流偏压降容；`CP_SW`–`CP_PUMP` 间直流偏压约 11 V）。
注意这会让 §9.5.4 的低占空比过压更确定，**所以必须先有半桥钳位**。

### 9.5.4 关键约束：启用电荷泵前必须给半桥板加钳位

倍压输出 `≈ 2×12 − 2×Vf`，ngspice 实测近空载 **21.7 V**（与手算 22 V 一致）。
代入 §0.1 的关系 `V_C3 = V_BOOST − Vf − V_HS`：

| 工况 | `V_C3` = `VHB−VHS` | 判定 |
|---|---|---|
| 低占空比 (`V_HS≈0`) | 21.7 − 0.8 = **20.9 V** | **超过 20 V 绝对最大值** |
| 接近 100% duty (`V_HS≈12`) | 21.7 − 0.8 − 12 = 8.9 V | 高于 7.9 V 最坏 UVLO ✓ |

也就是说约 22 V 能解决高占空比，但会在**正常低占空比工作点损坏驱动器**。
（这个结论在修正后的仿真下依然成立，见 §9.5.3 的实测表。）

根因是 §0.1 已给出的：`V_HS` 摆幅 12 V，而 `V_C3` 的允许窗口（UVLO 8 V ~ 推荐上限 17 V）
只有 9 V 宽，**没有任何固定 V_BOOST 能同时满足两端**。

→ **未加半桥钳位前不要启泵。** 输出直接驱动 `V_BOOST`（无 `JP1` 旁路 12 V）。
要在每块半桥板的 `C3`（HB–HS）两端加 **15 V 齐纳钳位** + `D1` 后串限流电阻。
加了钳位后：低占空比钳在 15 V ✓，100% duty 得 `min(21.7−0.8−12, 15) = 8.9 V` ✓。
高占空比余量偏薄（最坏 UVLO 7.9 V），这也是把 `C32` 加大到 220 nF 的另一个理由：
高 duty 时 `V_BOOST` 要顶住三路自举的补充电流，输出阻抗越低越好（§9.5.3 负载表）。

`D4` 在板上是 **3.3 V 状态 LED**（`R34` 限流），不是 V_BOOST 齐纳。
V_BOOST 过压保护仍须靠半桥板 HB–HS 钳位，不能靠主板齐纳。

### 9.5.5 固件优先级：电荷泵先于半桥供电

**电荷泵升压的优先级高于半桥输出使能。** 高边 MOSFET 要靠 `V_BOOST` / 自举电容上的
足够电压才能完全导通；`V_BOOST` 塌陷时，即使 TIM1 相位 PWM 已经输出，半桥也不能
当作“已供电”。

| 顺序 | 要求 |
|---|---|
| 1 | 上电后 `Boost_Poll()` 必须持续运行（主循环里**先于** `TnbMotor_Task` / 六步 / FOC），按 PA5 反馈调节 PA11 电荷泵 |
| 2 | **禁止**用 PA4 `VSENSE_12V` 作电荷泵反馈或 `Boost_Ready` 判据（该脚是 +12 V 分压，与 `V_BOOST` 无关） |
| 3 | **禁止**为了过软件门闩而长期把 TIM1_CH4（电荷泵开关）固定在关断；`Boost_Ready()==0` 时应加 duty、不应静默停泵 |
| 4 | `MotorPwm_ArmOutputs()`、MOE、六步换相**仅允许**在 `Boost_Ready()==1`（PA5 显示 `V_BOOST` 已达就绪窗口）且 nFAULT 未拉低之后 |
| 5 | 与 §9.5.4 硬件前提独立：未装半桥 HB–HS 钳位时，目标电压与启泵策略仍受该节约束；**一旦按实验要求启泵，运行循环里不得再擅自停泵** |

固件真源：`src/platforms/stm32f030/boost.c` / `boost.h`；状态字 `vboost=` 来自 PA5，
`vbus=`（若上报 PA4）表示 +12 V 监测，**不是** 24 V 母线。

---

## 9.6 PA14 复用 SWCLK / USART1_TX（已采纳）

### 9.6.1 决定与依据

`PA14 AF0 = SWCLK`，`AF1 = USART1_TX`（数据手册脚注 (2)：x4/x6 器件可用，K6 属于 x6）。
STM32 的 AF 多路器**同一时刻只能选一个功能**，两者互斥。

采纳复用，理由：I2C（PB6/PB7）是运行期控制接口不能占用；
而 SWCLK 只在调试期使用、串口日志只在发布后运行期使用，**时间上不重叠**。

关键支撑事实（数据手册 §3.5）：

> The boot loader is located in System Memory. It is used to reprogram the Flash
> memory by using USART on pins **PA14/PA15** or PA9/PA10.

**内置系统 bootloader 用的正是 PA14/PA15。** 所以发布固件占用 PA14 做 TX 之后，
仍可通过**同一条串口**、靠 BOOT0 拉高进 bootloader 重新烧录——
「失去 SWD」不再是变砖，而是换一条正常的烧录路径。
`PA15 AF1 = USART1_RX`，需要 RX 时可一并使用（发布版不跑 `motor_cycles.c` 的示波器测试点）。

### 9.6.2 前提：BOOT0 必须可设置（已添加）

原设计 BOOT0 只有 `R17` 10k 下拉、未引出任何位置，无法进 bootloader。已追加：

| 器件 | 连接 | 说明 |
|---|---|---|
| `JP3` Jumper_2_Open | `+3V3` ↔ `BOOT0` | 闭合 = 复位时 BOOT0 高 = 进 bootloader；断开时 `R17` 保持低（闭合时跳线胜出，耗流 330 µA） |
（BOOT0 的探测点就用 `JP3` pin 2，不另设测试点。）

两条恢复路径由此都成立：

| 路径 | 前提 | 现状 |
|---|---|---|
| SWD connect-under-reset | NRST 可控 + 固件不过早切 AF | `NRST → J9.5` 已引出，`openocd.cfg` 为 `srst_only` ✓ |
| 系统 bootloader（PA14/PA15 串口） | BOOT0 可拉高 | **`JP3` 已添加** ✓ |

### 9.6.3 调试口串阻（`R35`/`R36`，各 100 Ω）

PA14 复用 SWCLK / USART1_TX；PA13 复用 SWDIO / **红外输出**（`IR_OUT`）。
发布固件可能在两脚上推挽驱动，而调试器或红外接收头仍连着排针 → 须限流。

```
U1.24 (PA14) ── R35 100R ── SWCLK ── J9.3 / J12.2     （网表标签亦作 USART1_TX 注释）
U1.23 (PA13) ── R36 100R ── IR_OUT ── J9.2 / J11.2
U1.25 (PA15) ── TP1 (TP_CYCLE)                        （bootloader 时作 USART1_RX）
```

对顶电流约 **3.3 V / 100 Ω ≈ 33 mA**。`J9` **不引出 SWDIO**——全功能 SWD 需飞线到
MCU 侧测试点，或依赖 connect-under-reset + bootloader（§9.6.2）。

### 9.6.4 固件侧约束

1. **切 AF 的时机不能早。** connect-under-reset 需要探头有一个窗口。
   建议做成**编译期选择**：调试版保留 SWCLK，发布版才切 USART1_TX。
2. 若发布版也想保留可调试性，可用跳线/strap 或延时若干秒后再切。
3. **代价要认下来**：发布版单板无法用 SWD 做事后分析——
   例如读不出阶段 A1 的 trace 缓冲。实验板可接受，量产件需权衡。

原理图**布局以 KiCad 手工排版为准**；连接关系由 `pcb/tools/gen_schematic.py`
中的网表表维护，并与 `motor-ctrl-mainboard.kicad_sch` **保持同步**。
改连接：先改手工图或 `gen_schematic.py`（二者一致），再跑 `check_netlist.py`。
**勿盲目 `gen_schematic.py` 覆盖**已排版原理图——生成器只保证网表，不保留坐标。

```
pcb/
├── lib/motor-ctrl.kicad_sym      # 项目符号库（修正引脚的 INA240A2D_Fixed）
├── tools/
│   ├── ksym.py                   # 符号库读取 + extends 展平
│   ├── ksch.py                   # 原理图发射器（线头 + 网络标签）
│   ├── gen_schematic.py          # 网表真源 → 原理图
│   └── check_netlist.py          # 导出网表 vs 规格 / 数据手册 逐脚核验
└── mainboard/
    ├── motor-ctrl-mainboard.kicad_sch
    ├── motor-ctrl-mainboard.kicad_pro
    ├── sym-lib-table             # 注册项目库
    ├── net.net / erc.rpt / mainboard.pdf
```

### 10.1 重新生成与验证

```bash
KCLI=/Applications/KiCad/KiCad.app/Contents/MacOS/kicad-cli
cd pcb/tools && python3 gen_schematic.py
cd ../mainboard
$KCLI sch erc --severity-all -o erc.rpt motor-ctrl-mainboard.kicad_sch
$KCLI sch export netlist --format kicadsexpr -o net.net motor-ctrl-mainboard.kicad_sch
cd ../tools && python3 check_netlist.py       # 退出码非 0 即视为不可投板
```

当前状态（手工原理图）：**148 个器件**；网表校验见 `check_netlist.py`。
生成器与手工图**器件、参数逐项一致**（146 : 146），两边 `check_netlist.py` 均 0 失败。
生成器网表应与手工图一致；重新生成仅用于核对或空白起步，会丢失排版。

### 10.2 为什么用「线头 + 网络标签」风格

每个引脚接一段短线加一个网络标签，而不是画点对点连线。图不好看，但

- 连接关系由**标签**承载，与摆放位置无关——在 Eeschema 里重新排版**不会破坏网表**；
- 网表就是生成脚本里那张表所写的内容，可被 `check_netlist.py` 机器核验，
  不依赖人眼看图。

因此可以在 KiCad 里拖动器件、重排版面。**改连接**须改 `gen_schematic.py` 并重新生成；
重新生成会覆盖 `.kicad_sch` 上的手工连线，排版后若需保留布局请先备份或只在 Eeschema 里动位置。

### 10.3 `check_netlist.py` 核验的内容

**验证拓扑与功能，不验证网络名。** 手工连线处 KiCad 会自动命名（如 `Net-(J5-Pin_1)`），
所以分流链路检查的是「`J5.2` 是否经**恰好一个器件**到达 `U2` 的 `IN+`」，
而不是「那条网络是否叫 `SHU_P`」。这样在 Eeschema 里改标签、删标签都不会让校验失效，
只有真正改错接线才会。

| 检查项 | 依据 | 为何重要 |
|---|---|---|
| 3 × INA240 全部 8 脚（含拓扑） | TI SBOS712 Table 6-1 (D/SOIC) | **KiCad 自带符号 D/PW 引脚对调，接错即上电烧件**（§1.3） |
| MCU 全部 32 脚 | 本文 §3 / `board_pins.h` | 固件与硬件的唯一接口 |
| `J2..J4` / `J5..J7` | 半桥板 `J3` / `J2` 实际网表 | 接错会把 PWM 灌进分流节点 |
| **6 路过流 + 2 路过温，无置死单元** | 本文 §2 / §6.2 | 按**功能集合**判定，不锁定哪个物理单元做哪件事（编排是布局自由度） |
| `D5` 单向 OR 方向 + `nOTEMP` 唯一上拉 | 本文 §6.2 | 方向画反则过流会伪装成过温；重复上拉是画图漏删 |
| 输入保护链 `J1→F1→D6→+12V`、`D7` 在中间节点 | 本文 §4.1 | `D6` 方向画反则整板串一个反偏二极管；`D7` 位置决定 `F1` 能否保护它 |
| `D8` 引脚（1=GND, 2/3=I/O, 4=VCC） | Nexperia 数据表 | 逐脚核过数据表，不信符号（同 §1.3 的教训） |
| INA240 `REF1`/`REF2` 按**集合**判定 | 本文 §1.2.1 | 数据表称两脚无功能差异，分配是布局自由度 |
| `R37` + `J12` 三脚 UART | 本文 §9.6 | PA15 复用对顶保护 + bootloader 引脚对可达 |
| LM339 `V+` 必须在 `+12V` | 本文 §2.1 | 3.3 V 供电放不下 2.90 V 阈值 |
| 阈值分压串取自 `+3V3A` | 本文 §2 | 与 INA240 的 REF 同源才能比例跟踪 |
| PA4 / PA5 分压 | 本文 §9.5.1 / §9.5.2 | `vdc` 是 FOC 必需输入 |
| 3-BJT 电荷泵 + `V_BOOST` 直出 | 本文 §9.5.3 | 成本方案；无 TC4427 / 无 JP1 |
| `JP3` / NRST 恢复路径 | 本文 §9.6 | 复用后不能变砖 |
| `R35`/`R36` 串阻 | 本文 §9.6.3 | PA14/PA13 复用对顶保护 |
| `J21` 功率端子 | 本文 §5.1 | 与 `J1` 并联，母线电流的唯一出口 |
| `J8`/`J9`/`J10` **逐脚**引脚序 | 本文 §5 | 带电源脚的连接器接反会烧对面的东西；这几个曾在文档与板子之间漂移过 |
| 调试测试点 `TP1`…`TP23` | 本文 §6.1 | bench 探针，不改变功能网表 |
| 关键网络最小连接数 | — | 捕捉标签拼写错误导致的网络断裂 |

当前状态：**ERC 0 错误 + 2 警告**，`check_netlist.py` **0 失败**。

2 项警告是双重标签（`SWCLK`/`USART1_TX`、`IR_OUT`/`SWDIO`），无害，见 §10.4。

曾有 4 项 `power_pin_not_driven` 错误，落在 `+12V`（`U5.VI`）、`GND`（`U1.16`）、
`+3V3A`（`U1.5 VDDA`）、`V_BOOST`。原因是 KiCad 的电源符号引脚是 `power_in`，
必须有 `PWR_FLAG` 提供 `power_out` 才算「被驱动」，而手工图原先一个都没有。
现已补上 **`#FLG01`…`#FLG04`**（图纸右侧 x≈622~630 mm 处，各与一个同名电源符号短线相连），
纯 ERC 语义，网表零变化。

### 10.4 关于双重标签

原理图上多处同一网络挂了两个标签（如 `PWM_V_L` 与 `TIM1_CH2N`、`ADC_IN1` 与 `ISENSE_U`），
作为「信号名 + 外设功能」的双重注释。ERC 会报 `multiple_net_names` 警告，无害，
但要注意 **KiCad 取第一个名字进网表**。校验脚本按进入网表的那个名字判定。
