zhang1career/tars-motor-ctrl/models/INDEX.md

# benchgate 记录目录

> 由 benchgate 自动生成，请勿手改。源数据：`models/index.jsonl`，共 286 条。生成于 2026-10-21 15:05。

## 当前状态

没有仿真或 gate 记录。

| 类型 | 最近一次 | 结论 | 输入 | 摘要 | 记录 |
|---|---|---|---|---|---|
| 采集 | 2026-10-21 15:05 | 正常 | — | 附件 1 | `20261021T070554Z_fec8` |

## 记录（最新在前，最多 300 条）

### 2026-10-21

| 时间 | 类型 | 结论 | 摘要 | 目的 | 记录 |
|---|---|---|---|---|---|
| 15:05 | 采集 | 正常 | 附件 1 | hook 自动补记：models/captured/motor-resume-20261020/b2-iq200-dqv-verify-3-20261021.csv | `20261021T070554Z_fec8` |
| 15:05 | 采集 | 正常 | code, stopped, i24, hall 等 5 路 · 附件 1 | B2 iq200 verify-3 retry post-cleanup | `20261021T070502Z_dddc` |
| 15:04 | 采集 | 正常 | code, stopped, i24 | B2 iq200 verify-3 post-a926276 | `20261021T070411Z_271b` |
| 15:04 | 采集 | 正常 | code, stopped, i24, hall 等 5 路 · 附件 1 | B2 iq200 verify-2 post-a926276 | `20261021T070404Z_36df` |
| 15:03 | 采集 | 正常 | code, stopped, i24, hall 等 5 路 · 附件 1 | B2 iq200 verify-1 post-a926276 | `20261021T070354Z_134c` |
| 14:22 | 采集 | 正常 | code, stopped, i24, hall 等 5 路 · 附件 1 | post-boost-sfilt-moe-regression | `20261021T062255Z_5a32` |
| 14:22 | 采集 | 正常 | code, stopped, i24 | post-boost-sfilt-moe-regression | `20261021T062240Z_8129` |
| 14:22 | 采集 | 正常 | code, stopped, i24 | post-boost-sfilt-moe-regression | `20261021T062222Z_1c45` |

### 2026-10-20

| 时间 | 类型 | 结论 | 摘要 | 目的 | 记录 |
|---|---|---|---|---|---|
| 17:09 | 采集 | 正常 | 附件 1 | hook 自动补记：models/captured/motor-resume-20261020/vboost-foc-run-correlate.csv | `20261020T090919Z_8233` |
| 16:57 | 采集 | 正常 | 附件 1 | hook 自动补记：models/captured/motor-resume-20261020/vboost-run-watch.csv | `20261020T085758Z_be44` |
| 16:46 | 采集 | 正常 | code, stopped, i24, hall 等 5 路 · 附件 1 | B2 verify full window settle400ms | `20261020T084635Z_bec1` |
| 15:48 | 采集 | 正常 | code, stopped, i24 | stall retry dir1 | `20261020T074856Z_8857` |
| 15:48 | 采集 | 正常 | code, stopped, i24 | sanity iq200 after stall fails | `20261020T074844Z_0055` |
| 15:48 | 采集 | 正常 | code, stopped, i24 | STALL map iq300 no-bump | `20261020T074824Z_e3df` |
| 15:48 | 采集 | 正常 | code, stopped, i24 | STALL map iq280 no-bump | `20261020T074812Z_a6ca` |
| 15:47 | 采集 | 正常 | code, stopped, i24 | STALL map iq250 no-bump | `20261020T074759Z_d8fb` |
| 15:47 | 采集 | 正常 | code, stopped, i24 | STALL boundary retry | `20261020T074741Z_3628` |
| 15:47 | 采集 | 正常 | code, stopped, i24 | STALL boundary iq300 | `20261020T074720Z_26a2` |
| 15:47 | 采集 | 正常 | code, stopped, i24 | STALL boundary iq280 | `20261020T074707Z_bfd6` |
| 15:46 | 采集 | 正常 | code, stopped, i24 | STALL boundary iq250 | `20261020T074655Z_4ffd` |
| 15:38 | 采集 | 正常 | 附件 1 | hook 自动补记：models/captured/motor-resume-20261020/b2-iq200-dqv-verify-4a.csv | `20261020T073815Z_8349` |
| 15:38 | 采集 | 正常 | code, stopped, i24, hall 等 5 路 · 附件 1 | B2 verify-4 retry 4c | `20261020T073802Z_7a59` |
| 15:37 | 采集 | 正常 | code, stopped, i24, hall 等 5 路 · 附件 1 | B2 verify-4 retry 4b | `20261020T073755Z_d2ec` |
| 15:37 | 采集 | 正常 | code, stopped, i24 | B2 verify-4 retry 4a | `20261020T073748Z_0830` |
| 15:37 | 采集 | 正常 | code, stopped, i24, hall 等 5 路 · 附件 1 | B2 verify-4 replacement full window | `20261020T073738Z_f0df` |
| 15:37 | 采集 | 正常 | code, stopped, i24, hall 等 5 路 · 附件 1 | B2 verify-4 replacement third full window | `20261020T073702Z_7d93` |
| 15:27 | 采集 | 正常 | code, stopped, i24, hall 等 5 路 · 附件 1 | B2 verify 3 settle400ms | `20261020T072703Z_0ae0` |
| 15:26 | 采集 | 正常 | code, stopped, i24, hall 等 5 路 · 附件 1 | B2 verify 2 settle400ms | `20261020T072658Z_5cf4` |
| 15:26 | 采集 | 正常 | code, stopped, i24, hall 等 5 路 · 附件 1 | B2 verify 1 settle400ms | `20261020T072652Z_0160` |
| 15:26 | 采集 | 正常 | code, stopped, i24, hall 等 5 路 · 附件 1 | B2 verify 3 post TARS reset | `20261020T072621Z_de8e` |
| 15:26 | 采集 | 正常 | code, stopped, i24, hall 等 5 路 · 附件 1 | B2 verify 2 post TARS reset | `20261020T072615Z_76cd` |
| 15:26 | 采集 | 正常 | code, stopped, i24, hall 等 5 路 · 附件 1 | B2 verify 1 post TARS reset | `20261020T072609Z_6f9d` |
| 15:16 | 采集 | 正常 | code, stopped, i24 | B2 verify 3 retry | `20261020T071635Z_e908` |
| 15:16 | 采集 | 正常 | code, stopped, i24 | B2 verify 2 retry | `20261020T071631Z_0c61` |
| 15:16 | 采集 | 正常 | code, stopped, i24 | B2 verify 1 retry | `20261020T071627Z_fc25` |
| 15:16 | 采集 | 正常 | code, stopped, i24, hall 等 5 路 · 附件 1 | B2 verify run 3 post-review | `20261020T071609Z_9d34` |
| 15:16 | 采集 | 正常 | code, stopped, i24 | B2 verify run 2 post-review | `20261020T071603Z_03eb` |
| 15:15 | 采集 | 正常 | code, stopped, i24 | B2 verify run 1 post-review | `20261020T071559Z_b336` |
| 14:57 | 采集 | 正常 | code, stopped, i24, hall 等 5 路 · 附件 1 | B2 confirm iq210 | `20261020T065741Z_a87f` |
| 14:57 | 采集 | 正常 | code, stopped, i24, hall 等 5 路 · 附件 1 | B2 confirm iq200 | `20261020T065735Z_1a4b` |
| 14:57 | 采集 | 正常 | code, stopped, i24, hall 等 5 路 · 附件 1 | iq300 retry after clr | `20261020T065725Z_e65c` |
| 14:57 | 采集 | 正常 | code, stopped, i24, hall 等 5 路 · 附件 1 | autodrive iq270 | `20261020T065715Z_f677` |
| 14:57 | 采集 | 正常 | code, stopped, i24, hall 等 5 路 · 附件 1 | autodrive iq215 | `20261020T065710Z_2f80` |
| 14:57 | 采集 | 正常 | code, stopped, i24, hall 等 5 路 · 附件 1 | autodrive iq210 | `20261020T065705Z_f928` |
| 14:54 | 采集 | 正常 | code, stopped, i24, hall 等 5 路 · 附件 1 | iq300 near iqmax | `20261020T065426Z_5865` |
| 14:54 | 采集 | 正常 | code, stopped, i24, hall 等 5 路 · 附件 1 | iq280 stall boundary | `20261020T065421Z_2159` |
| 14:54 | 采集 | 正常 | code, stopped, i24, hall 等 5 路 · 附件 1 | B2 iq235 PA5 DMA ok | `20261020T065415Z_e627` |
| 14:41 | 采集 | 正常 | 附件 2 | hook 自动补记：models/captured/trace-foc_dqv-20261020-143742.csv、models/captured/trace-foc_dqv-20261020-143742.png | `20261020T064132Z_9a35` |
| 14:41 | 采集 | 正常 | code, stopped, i24 | B2 iq235 with PA5 DMA live | `20261020T064126Z_c6a1` |
| 14:39 | 采集 | 正常 | code, stopped, i24, hall 等 5 路 · 附件 1 | B2 iq235 post PA5 DMA fix | `20261020T063941Z_c926` |
| 14:38 | 采集 | 正常 | code, stopped, i24, hall 等 5 路 · 附件 1 | B2 iq235 tune ~200mA | `20261020T063820Z_7186` |
| 14:38 | 采集 | 正常 | code, stopped, i24, hall 等 5 路 · 附件 1 | B2 iq230 post-clr autodrive | `20261020T063804Z_c49f` |
| 14:37 | 采集 | 正常 | code, stopped, i24, hall 等 5 路 · 附件 1 | B2 iq250 post-clr autodrive | `20261020T063759Z_0c30` |
| 14:37 | 采集 | 正常 | code, stopped, i24, hall 等 5 路 · 附件 1 | B2 iq225 toward 200mA avg | `20261020T063731Z_2f11` |
| 14:37 | 采集 | 正常 | code, stopped, i24, hall 等 5 路 · 附件 1 | B2 iq200mA dqv autodrive | `20261020T063720Z_6e51` |
| 14:37 | 采集 | 正常 | code, stopped, i24, hall 等 5 路 · 附件 1 | B2 iq220mA dqv autodrive | `20261020T063715Z_54ad` |
| 14:37 | 采集 | 正常 | code, stopped, i24, hall 等 5 路 · 附件 1 | B2 iq250 single window repeat | `20261020T063706Z_2606` |
| 14:36 | 采集 | 正常 | code, stopped, i24, hall 等 5 路 · 附件 1 | B2 iq250 multi-window slow rotation | `20261020T063644Z_257b` |
| 14:35 | 采集 | 正常 | code, stopped, i24, hall 等 5 路 · 附件 1 | B2 sweep 300mA foc_dqv | `20261020T063516Z_b334` |
| 14:35 | 采集 | 正常 | code, stopped, i24, hall 等 5 路 · 附件 1 | B2 sweep 250mA foc_dqv | `20261020T063511Z_23f3` |
| 14:35 | 采集 | 正常 | code, stopped, i24, hall 等 5 路 · 附件 1 | B2 sweep 200mA foc_dqv | `20261020T063506Z_0ba9` |
| 14:34 | 采集 | 正常 | code, stopped, i24, hall 等 5 路 · 附件 1 | B2 200mA any-motion (rotor may move) | `20261020T063416Z_4c35` |
| 14:33 | 采集 | 正常 | code, stopped, i24 | B2 200mA q hold (iq in mA) | `20261020T063357Z_68dc` |
| 14:33 | 采集 | 正常 | code, stopped, i24, hall 等 5 路 · 附件 1 | B2 ~200mA q hold V_BOOST ~32V swing | `20261020T063303Z_9932` |
| 14:30 | 采集 | 正常 | code, stopped, i24, hall 等 5 路 · 附件 1 | iq0 after PA5 boost fallback fix | `20261020T063044Z_6028` |
| 14:12 | 采集 | 正常 | code, stopped, i24 | iq0 retry V_BOOST ~32V stable | `20261020T061222Z_351d` |
| 13:44 | 采集 | 正常 | code, stopped, i24 | motor resume iq0 after boost pause | `20261020T054409Z_57cb` |
| 13:31 | 采集 | 正常 | 附件 3 | hook 自动补记：models/captured/boost-idle-watch-20261020-anchor-dither.csv、models/captured/boost-idle-watch-20261020-post-dither.csv、models/captured/boost-idle-watch-20261020-pre-dither.csv | `20261020T053110Z_c100` |
| 12:03 | 采集 | 正常 | 附件 4 | hook 自动补记：models/captured/foc-b2-20261020/review-step1-idle-ccr4.csv、models/captured/foc-b2-20261020/review-step1-scope-20261020-115933.csv、models/captured/foc-b2-20261020/review-step1-scope-20261020-115933.png、models/captured/foc-b2-20261020/review-step1-scope-run2-20261020.csv | `20261020T040318Z_21a6` |
| 12:01 | 采集 | 正常 | code, stopped, i24, hall 等 5 路 · 附件 1 | review step1 32V stall V_BOOST+UVW scope | `20261020T040111Z_f2fc` |
| 11:58 | 采集 | 正常 | code, stopped, i24, hall 等 5 路 · 附件 1 | review step1 32V stall V_BOOST+UVW scope | `20261020T035842Z_9237` |
| 11:58 | 采集 | 正常 | code, stopped, i24, hall 等 5 路 · 附件 1 | review step1 32V stall V_BOOST+UVW scope | `20261020T035810Z_ce7c` |
| 11:30 | 采集 | 正常 | code, stopped, i24 | spin check after 500ms rails revert | `20261020T033056Z_8b6e` |
| 11:26 | 采集 | 正常 | code, stopped, i24 | iq0 nudge 400mA 3s for hall edges | `20261020T032609Z_8a81` |
| 11:24 | 采集 | 正常 | code, stopped, i24 | iq0 dir1 no bump STALL debug | `20261020T032438Z_0694` |
| 11:24 | 采集 | 正常 | code, stopped, i24 | iq0 no bump STALL debug | `20261020T032420Z_bfe3` |
| 11:23 | 采集 | 正常 | code, stopped, i24 | 判据1 iq0 Oct20 autodrive | `20261020T032318Z_2bb2` |
| 11:07 | 采集 | 正常 | code, stopped, i24 | B2 200mA Oct20 dir1 after STALL | `20261020T030702Z_8d0e` |
| 11:06 | 采集 | 正常 | code, stopped, i24 | B2 200mA Oct20 post clr | `20261020T030607Z_c292` |
| 11:02 | 采集 | 正常 | code, stopped, i24 | 判据1 iq0 after boost 32V fix | `20261020T030253Z_999b` |
| 10:54 | 采集 | 正常 | code, stopped, i24 | B2 Oct20 after clr | `20261020T025427Z_cc4e` |
| 10:49 | 采集 | 正常 | code, stopped, i24 | B2 200mA continue exp Oct20 | `20261020T024904Z_7cc7` |
| 00:21 | 采集 | 正常 | code, stopped, i24 | B2 validation autonomous run | `20261019T162146Z_1852` |
| 00:09 | 采集 | 正常 | code, stopped, i24 | B2 200mA validation after U driver; no hall lock | `20261019T160931Z_b4ca` |

### 2026-10-19

| 时间 | 类型 | 结论 | 摘要 | 目的 | 记录 |
|---|---|---|---|---|---|
| 23:44 | 采集 | 正常 | code, stopped, i24 | B2 200mA no-bump; no hall lock; after kill openocd | `20261019T154449Z_3c01` |
| 23:44 | 采集 | 正常 | code, stopped, i24 | B2 200mA no-bump; openocd restarted clean after kill daemon | `20261019T154423Z_3774` |
| 23:41 | 采集 | 正常 | code, stopped, i24 | B2 200mA no-bump after U UCC27211 + SWD rewired | `20261019T154140Z_a809` |
| 23:39 | 采集 | 正常 | code, stopped, i24 | B2 200mA no-bump after U driver fix; retake empty sessions | `20261019T153952Z_9cf7` |
| 23:37 | 采集 | 正常 | 附件 4 | hook 自动补记：models/captured/foc-b2-20261019/scope-stop-retake-ch1.csv、models/captured/foc-b2-20261019/scope-stop-retake-ch2.csv、models/captured/foc-b2-20261019/scope-stop-retake-ch3.csv、models/captured/foc-b2-20261019/scope-stop-retake-ch4.csv | `20261019T153713Z_6084` |
| 23:35 | 采集 | 正常 | code, stopped, i24 | B2 200mA no-bump after U driver fix; retake empty sessions | `20261019T153559Z_9096` |
| 23:34 | 采集 | 正常 | code, stopped, i24 | B2 200mA no-bump after U driver fix; retake empty sessions | `20261019T153447Z_2bc9` |
| 23:26 | 采集 | 正常 | 附件 8 | hook 自动补记：models/captured/foc-b2-20261019/scope-nfault-run-after-u-driver.csv、models/captured/foc-b2-20261019/scope-stop-u-driver-fix-ch1.csv、models/captured/foc-b2-20261019/scope-stop-u-driver-fix-ch2.csv、models/captured/foc-b2-20261019/scope-stop-u-driver-fix-ch3.csv、models/captured/foc-b2-20261019/scope-stop-u-driver-fix-ch4.csv、models/captured/foc-b2-20261019/scope-u-run-after-u-driver.csv、models/captured/foc-b2-20261019/scope-v-run-after-u-driver.csv、models/captured/foc-b2-20261019/scope-w-run-after-u-driver.csv | `20261019T152626Z_c643` |
| 23:19 | 采集 | 正常 | code, stopped, i24 | B2 after U UCC27211 replace; U baseline 1.64V | `20261019T151902Z_779d` |
| 23:14 | 采集 | 正常 | code, stopped, i24 | B2 repeat after UCC27211 U-phase fix | `20261019T151425Z_0bfd` |
| 17:00 | 采集 | 正常 | 附件 3 | hook 自动补记：models/captured/foc-b2-20261019/scope-stop-ch1.csv、models/captured/foc-b2-20261019/scope-stop-ch2.csv、models/captured/foc-b2-20261019/scope-stop-ch3.csv | `20261019T090031Z_7f8e` |
| 17:00 | 采集 | 正常 | code, stopped, i24, hall · 附件 1 | KCL i0 at ADC sample instants | `20261019T090005Z_26b5` |
| 16:52 | 采集 | 正常 | 附件 4 | hook 自动补记：models/captured/foc-b2-20261019/scope-nfault-run.csv、models/captured/foc-b2-20261019/scope-u-run.csv、models/captured/foc-b2-20261019/scope-v-run.csv、models/captured/foc-b2-20261019/scope-w-run.csv | `20261019T085220Z_f135` |
| 16:49 | 采集 | 正常 | code, stopped, i24, hall 等 5 路 · 附件 1 | B2 no bump hall6 start | `20261019T084922Z_b3db` |
| 16:33 | 采集 | 正常 | code, stopped, i24 | 200mA vd/vq vs temp ceiling | `20261019T083354Z_58ce` |
| 15:02 | 采集 | 正常 | 附件 2 | hook 自动补记：models/captured/ceil-20261019/scope-u-hall6.csv、models/captured/ceil-20261019/scope-v-hall6.csv | `20261019T070209Z_e6b9` |
| 14:03 | 采集 | 正常 | 附件 4 | hook 自动补记：models/captured/ceil-20261019/scope-nfault-stop.csv、models/captured/ceil-20261019/scope-u-stop.csv、models/captured/ceil-20261019/scope-v-stop.csv、models/captured/ceil-20261019/scope-w-stop.csv | `20261019T060357Z_ec33` |
| 13:41 | 采集 | 正常 | 附件 1 | hook 自动补记：models/captured/ceil-20261019/scope-u.csv | `20261019T054123Z_bbb6` |
| 05:22 | 采集 | 正常 | code, stopped, i24 | 三相放大器输出对照：200毫安起转一次 | `20261018T212246Z_d086` |
| 04:27 | 采集 | 正常 | code, stopped, i24 | 示波器看三相放大器输出时，同一次运行的相电流原始值 | `20261018T202739Z_c434` |
| 04:07 | 采集 | 正常 | 附件 1 | hook 自动补记：models/captured/hook-record-captures-selftest/hook-record-captures-selftest.csv | `20261018T200759Z_20c9` |

### 2026-10-18

| 时间 | 类型 | 结论 | 摘要 | 目的 | 记录 |
|---|---|---|---|---|---|
| 15:03 | 采集 | 正常 | code, stopped, i24, hall · 附件 5 | 静止时 d轴0/6/12刻度轮流 看相电流读数误差 c | `20261018T070321Z_403c` |
| 15:03 | 采集 | 正常 | code, stopped, i24, hall · 附件 5 | 静止时 d轴0/6/12刻度轮流 看相电流读数误差 b | `20261018T070307Z_738b` |
| 15:02 | 采集 | 正常 | code, stopped, i24, hall · 附件 5 | 静止时 d轴0/6/12刻度轮流 看相电流读数误差 a | `20261018T070254Z_51bf` |
| 14:52 | 采集 | 正常 | code, stopped, i24, hall · 附件 1 | 静止时相电流误差 和升压占空比对照 | `20261018T065235Z_82c2` |
| 14:52 | 采集 | 正常 | code, stopped, i24, hall · 附件 1 | 静止时相电流误差 和升压占空比对照 | `20261018T065223Z_230e` |
| 14:52 | 采集 | 正常 | code, stopped, i24, hall · 附件 1 | 静止时相电流误差 和升压占空比对照 | `20261018T065210Z_764f` |
| 14:51 | 采集 | 正常 | code, stopped, i24, hall · 附件 1 | 静止时相电流误差 和升压占空比对照 | `20261018T065157Z_babc` |
| 14:51 | 采集 | 正常 | code, stopped, i24, hall · 附件 1 | 静止时相电流误差 和升压占空比对照 | `20261018T065145Z_a1df` |
| 14:51 | 采集 | 正常 | code, stopped, i24, hall · 附件 1 | 静止时相电流误差 和升压占空比对照 | `20261018T065132Z_049a` |
| 14:41 | 采集 | 正常 | code, stopped, i24, hall · 附件 1 | 静止时三相电流原始值 对照转动时的测量误差 | `20261018T064101Z_3a7d` |
| 14:40 | 采集 | 正常 | code, stopped, i24, hall · 附件 1 | 静止时三相电流原始值 对照转动时的测量误差 | `20261018T064042Z_81e4` |
| 14:40 | 采集 | 正常 | code, stopped, i24, hall · 附件 1 | 静止时三相电流原始值 对照转动时的测量误差 | `20261018T064003Z_847d` |
| 14:32 | 采集 | 正常 | code, stopped, i24, hall · 附件 10 | 转得快时 三相电流原始值 检查测量 | `20261018T063234Z_23e3` |
| 14:21 | 采集 | 正常 | code, stopped, i24, hall 等 5 路 · 附件 7 | 转得快时：同一次转动里死区补偿 开关开 轮流对照 | `20261018T062125Z_c4e2` |
| 14:07 | 采集 | 正常 | code, stopped, i24, hall 等 5 路 · 附件 10 | 转得快时失控：同窗记录 id iq vd vq 角度 | `20261018T060735Z_f83c` |
| 14:06 | 采集 | 正常 | code, stopped, i24, hall 等 5 路 · 附件 10 | 转得快时失控：同窗记录 id iq vd vq 角度 | `20261018T060639Z_f349` |
| 13:08 | 采集 | 正常 | code, stopped, i24, hall 等 5 路 · 附件 30 | 判据4：同窗带电压的q轴200到300mA阶跃 30窗 | `20261018T050840Z_d9a9` |
| 13:07 | 采集 | 正常 | code, stopped, i24, hall 等 5 路 · 附件 30 | 判据4：同窗带电压的q轴200到300mA阶跃 30窗 | `20261018T050738Z_b04d` |
| 12:59 | 采集 | 正常 | code, stopped, i24, hall 等 5 路 · 附件 30 | 判据4：q轴200到300mA阶跃 30窗 | `20261018T045923Z_8916` |
| 12:58 | 采集 | 正常 | code, stopped, i24, hall 等 5 路 · 附件 8 | 判据4前：确认低电压状态 | `20261018T045804Z_fb3d` |
| 12:57 | 采集 | 正常 | code, stopped, i24, hall 等 5 路 · 附件 8 | 判据4前：确认低电压状态 | `20261018T045729Z_ed7d` |
| 12:56 | 采集 | 正常 | code, stopped, i24, hall 等 5 路 · 附件 1 | 判据1：q轴指令0时不再重起六步 静止窗 | `20261018T045652Z_7e63` |
| 12:56 | 采集 | 正常 | code, stopped, i24, hall 等 5 路 · 附件 1 | 判据1：q轴指令0时不再重起六步 静止窗 | `20261018T045637Z_5379` |
| 12:56 | 采集 | 正常 | code, stopped, i24, hall 等 5 路 · 附件 1 | 判据1：q轴指令0时不再重起六步 静止窗 | `20261018T045620Z_1318` |
| 12:14 | 采集 | 正常 | code, stopped, i24, hall 等 5 路 · 附件 12 | 判据3重采12窗 看窗5那种失控会不会再出现 | `20261018T041417Z_025d` |
| 12:10 | 采集 | 正常 | code, stopped, i24, hall 等 5 路 · 附件 6 | 判据3条件下 看失控窗是否都碰电压上限 | `20261018T041025Z_3b67` |
| 12:00 | 采集 | 正常 | code, stopped, i24, hall 等 5 路 · 附件 1 | 判据1：q轴指令0 不等停稳 只用角度不动的窗 | `20261018T040007Z_250e` |
| 12:00 | 采集 | 正常 | code, stopped, i24, hall 等 5 路 · 附件 1 | 判据1：q轴指令0 不等停稳 只用角度不动的窗 | `20261018T040001Z_c631` |
| 11:59 | 采集 | 正常 | code, stopped, i24, hall 等 5 路 · 附件 1 | 判据1：q轴指令0 不等停稳 只用角度不动的窗 | `20261018T035955Z_6cb0` |
| 11:58 | 采集 | 正常 | code, stopped, i24, hall 等 5 路 · 附件 6 | 判据3：d轴保持6刻度 六个位置 按角度算转速筛窗 | `20261018T035854Z_e284` |
| 11:51 | 采集 | 正常 | code, stopped, i24 | 判据1：转子静止 q轴指令0 | `20261018T035132Z_daf9` |
| 11:49 | 采集 | 正常 | code, stopped, i24, hall 等 5 路 · 附件 30 | 判据2：200mA 转动 d轴阶跃6刻度 30窗 按角度算转速筛窗 | `20261018T034921Z_3e6b` |
| 11:38 | 采集 | 正常 | code, stopped, i24, hall 等 5 路 · 附件 8 | 转矩模式 q轴200到300mA阶跃 看vd vq是否碰上限 | `20261018T033830Z_1eaa` |
| 11:37 | 采集 | 正常 | code, stopped, i24, hall 等 5 路 · 附件 8 | 200mA 转动 d轴阶跃6刻度 看vd vq是否碰上限 | `20261018T033759Z_d961` |
| 11:35 | 采集 | 正常 | code, stopped, i24, hall 等 5 路 · 附件 1 | 1.6V上限 200mA 第三窗 看vq贴上限比例 | `20261018T033522Z_d465` |
| 11:35 | 采集 | 正常 | code, stopped, i24, hall 等 5 路 · 附件 1 | 1.6V上限 200mA 第二窗 看vq贴上限比例 | `20261018T033506Z_c3d9` |
| 11:32 | 采集 | 正常 | code, stopped, i24, hall 等 5 路 · 附件 1 | 1.6V上限 200mA 看转速和d轴电流，区分反电动势和角度 | `20261018T033220Z_7329` |
| 11:27 | 采集 | 正常 | code, stopped, i24, hall 等 5 路 · 附件 1 | 1.6V上限 200mA 看vq是否贴上限 | `20261018T032710Z_5c0f` |

### 2026-10-17

| 时间 | 类型 | 结论 | 摘要 | 目的 | 记录 |
|---|---|---|---|---|---|
| 16:04 | 采集 | 正常 | code, stopped, i24 | ADC触发周期改成2398后再起转 | `20261017T080422Z_0e94` |
| 15:54 | 采集 | 正常 | code, stopped, i24 | 过流清除后再试一次，看升压和电流 | `20261017T075450Z_8e50` |
| 15:49 | 采集 | 正常 | code, stopped, i24 | 升压带着电机第一次转，看32伏会不会掉 | `20261017T074957Z_778d` |

### 2026-10-15

| 时间 | 类型 | 结论 | 摘要 | 目的 | 记录 |
|---|---|---|---|---|---|
| 18:32 | 采集 | 正常 | crit1_n, crit1_id_mean, crit1_iq_mean, crit1_theta_span 等 26 路 | Rescore the four current-loop checks on the firmware that includes stall recovery | `20261015T103258Z_5438` |
| 18:32 | 采集 | 正常 | code, stopped, i24, hall 等 5 路 · 附件 8 | 重测电流环判据4的电压：iq 阶跃到 300 mA 时 vd vq 是否顶到上限 | `20261015T103232Z_c2ab` |
| 18:32 | 采集 | 正常 | code, stopped, i24, hall 等 5 路 · 附件 8 | 重测电流环判据2的电压：id 阶跃到 6 LSB 时 vd vq 是否顶到上限 | `20261015T103222Z_010e` |
| 18:31 | 采集 | 正常 | code, stopped, i24, hall 等 5 路 · 附件 30 | 重测电流环判据4：转矩模式 iq 从 200 mA 阶跃到 300 mA | `20261015T103120Z_0252` |
| 18:30 | 采集 | 正常 | code, stopped, i24, hall 等 5 路 · 附件 30 | 重测电流环判据2和3：200 mA 转动时 id 从 0 阶跃到 6 LSB | `20261015T103036Z_a967` |
| 18:14 | 采集 | 正常 | tick_first, tick_min, tick_common, tick_common_n 等 9 路 | Remeasure the control tick after the recovery path stopped resetting a moving rotor | `20261015T101410Z_f42e` |
| 17:42 | 采集 | 正常 | restarts_before, sixstep_samples_before, torque_samples_before, bus_max_a_before 等 11 路 | Compare stall false-triggers during a loaded spin before and after ignoring slow hall edges | `20261015T094258Z_6809` |
| 17:26 | 采集 | 正常 | tick_first, tick_steady_min, tick_steady_common, tick_steady_max 等 7 路 · MotorTick_OnAdcComplete | 32-tick remeasure after stall restart waits for a fast six-step sector before handing back to the current loop | `20261015T092649Z_7922` |
| 16:10 | 采集 | 正常 | tick_first, tick_steady_min, tick_steady_common, tick_steady_max 等 7 路 · MotorTick_OnAdcComplete | 32-tick remeasure after reverting stall crawl and lead; hold the hall center and drop the pre-stall speed | `20261015T081054Z_fce2` |
| 15:59 | 采集 | 正常 | tick_first, tick_steady_min, tick_steady_common, tick_steady_max 等 7 路 · MotorTick_OnAdcComplete | 32-tick remeasure after stall lead-hold: angle stays one sector ahead instead of free-running | `20261015T075915Z_1e67` |
| 15:50 | 采集 | 正常 | tick_first, tick_steady_min, tick_steady_common, tick_steady_max 等 7 路 · MotorTick_OnAdcComplete | 32-tick remeasure after stall crawl: angle creeps instead of holding the hall center | `20261015T075043Z_651f` |
| 15:44 | 采集 | 正常 | edge_cycles, steady_common_cycles, steady_short_cycles, flash_bytes 等 5 路 | 刹车后不再沿用旧速度。桥关断 32 拍：换边 1581，常见稳态 1222。 | `20261015T074436Z_14be` |
| 15:24 | 采集 | 正常 | edge_cycles, steady_short_cycles, steady_common_cycles, steady_common_count 等 6 路 | 停转恢复改完之后量 32 拍。换边 1557，短稳态 1202，常见的是 1212。 | `20261015T072420Z_dd21` |
| 15:23 | 采集 | 正常 | code, stopped, i24, hall 等 5 路 · 附件 8 | 停转后角度回到霍尔中心，先确认正常转动没有被误判成停转 | `20261015T072357Z_01f3` |
| 14:43 | 采集 | 正常 | code, stopped, i24, hall 等 5 路 · 附件 20 | 正转 200 毫安给人看，状态查询密一些，看完就停 | `20261015T064340Z_a8c3` |
| 14:42 | 采集 | 正常 | code, stopped, i24, hall 等 5 路 · 附件 1 | 正转 200 毫安给人看，看完就停 | `20261015T064228Z_c1df` |
| 14:32 | 采集 | 正常 | id_mean_lsb, iq_mean_lsb, theta_travel_q15, cmd | 方向 1 转了一次，霍尔角度表的另一行跑到了。d 轴均值 0.04 个刻度，q 轴均值 12.48。 | `20261015T063250Z_9659` |
| 14:32 | 采集 | 正常 | code, stopped, i24, hall 等 5 路 · 附件 1 | 方向 1 转一次，让霍尔角度表的另一行真正跑到 | `20261015T063213Z_83e1` |
| 14:31 | 采集 | 正常 | id_mean_lsb, iq_mean_lsb, samples, cmd | 当前镜像上转子停着、q 轴指令 0。d 轴均值 0.013 个刻度，q 轴均值 -0.019 个刻度。 | `20261015T063159Z_4540` |
| 14:31 | 采集 | 正常 | code, stopped, i24, hall 等 5 路 · 附件 1 | 当前镜像上转子停着、q 轴指令 0，看 d 轴和 q 轴均值 | `20261015T063137Z_8b10` |
| 14:31 | 采集 | 正常 | id_step_vd_abs_max_mv, id_step_vq_max_mv, iq_step_vd_abs_max_mv, iq_step_vq_max_mv 等 5 路 | 两次阶跃的 d、q 轴电压都没有顶到上限，饱和标志为 0。 | `20261015T063102Z_6509` |
| 14:30 | 采集 | 正常 | code, stopped, i24, hall 等 5 路 · 附件 2 | q 轴从 200 毫安到 300 毫安时看 d、q 轴电压有没有顶到上限 | `20261015T063042Z_b2db` |
| 14:30 | 采集 | 正常 | code, stopped, i24, hall 等 5 路 · 附件 2 | d 轴阶跃时看 d、q 轴电压有没有顶到上限 | `20261015T063032Z_2a5d` |
| 14:30 | 采集 | 正常 | windows, cross_80_ms, first_1ms_mean_lsb, roll_1ms_peak_lsb 等 13 路 | q 轴从 12 个刻度阶跃到 18，30 窗按指令列对齐。1 毫秒内到 80%，2 毫秒后均值 17.981。按 1 毫秒平均看，超调约 9.5%。 | `20261015T063016Z_ebd7` |
| 14:29 | 采集 | 正常 | code, stopped, i24, hall 等 5 路 · 附件 30 | q 轴从 200 毫安阶跃到 300 毫安，抽样 0.1 毫秒，30 窗，用指令列找阶跃时刻 | `20261015T062928Z_ce0f` |
| 14:28 | 采集 | 正常 | windows, cross_80_ms, first_1ms_mean_lsb, roll_1ms_peak_lsb 等 13 路 | d 轴阶跃 6 个刻度、30 窗按指令列对齐。1 毫秒内到 80%，2 毫秒后均值 6.005。按 1 毫秒平均看，超调约 3.6%。 | `20261015T062842Z_21c6` |
| 14:27 | 采集 | 正常 | code, stopped, i24, hall 等 5 路 · 附件 30 | d 轴阶跃 6 个刻度，抽样 0.1 毫秒，30 窗，用指令列找阶跃时刻 | `20261015T062717Z_df7b` |
| 14:26 | 采集 | 正常 | edge_cycles, steady_short_cycles, steady_short_count, steady_max_cycles 等 6 路 | 电流环轨迹第 4 列改成指令之后，桥关断量 32 拍。这一版镜像换边 1524，短稳态 1193。短的那条没有变长。 | `20261015T062632Z_cbd0` |
| 14:24 | 采集 | 正常 | tick_max, overrun, tick_total, tick_sum | 退掉换边推迟存点之后的一次 200 毫安正转。最长拍 1673，没有超时。 | `20261015T062458Z_9bd2` |
| 14:24 | 采集 | 正常 | code, stopped, i24, hall 等 5 路 · 附件 1 | 退掉换边推迟存点之后，读一次 200 毫安正转的最长拍 | `20261015T062417Z_10a8` |
| 14:23 | 采集 | 正常 | edge_cycles, steady_short_cycles, steady_floor_cycles, steady_floor_count 等 7 路 | 退掉换边推迟存点之后，桥关断时量 32 拍。换边那拍 1554，短的稳态仍是 1212，后面 23 拍落在 8% 占空比下限那条路径 1275。 | `20261015T062353Z_4ddb` |
| 13:21 | 采集 | 正常 | iq_base_lsb, iq_cmd_lsb, hit_80_ms, peak_1ms_lsb 等 10 路 | 电流环第4条：转矩模式下 q 轴阶跃约 100 mA，看 1 ms、2 ms 和电压上限 | `20261015T052117Z_740e` |
| 13:20 | 采集 | 正常 | code, stopped, i24, hall 等 5 路 · 附件 4 | 电流环第4条：q 轴从 200 毫安阶跃到 300 毫安，同时看电压 | `20261015T052032Z_b84d` |
| 13:18 | 采集 | 正常 | code, stopped, i24, hall 等 5 路 · 附件 4 | 电流环第4条：转矩模式 q 轴从 12 阶跃到 18 个刻度，同时看电压 | `20261015T051836Z_35de` |
| 13:18 | 采集 | 正常 | stair0_mean, stair0_n, stair1_mean, stair1_n 等 13 路 | 电流环第3条：d 轴保持 6 个刻度转过一圈，六个扇区的均值 | `20261015T051822Z_9f74` |
| 13:17 | 采集 | 正常 | code, stopped, i24, hall 等 5 路 · 附件 3 | 电流环第3条：d 轴保持 6 个刻度，盖住一圈的六个扇区 | `20261015T051742Z_e041` |
| 13:17 | 采集 | 正常 | id_base_lsb, hit_80_ms, overshoot_pct, id_tail_lsb 等 10 路 | 电流环第2条：200 mA 慢转时 d 轴阶跃 6 个刻度，四窗平均后判 1 ms、2 ms 和电压上限 | `20261015T051720Z_9191` |
| 13:15 | 采集 | 正常 | code, stopped, i24, hall 等 5 路 · 附件 2 | 电流环第2条：d 轴阶跃时 vd、vq 是否顶到上限 | `20261015T051551Z_b9cc` |
| 13:13 | 采集 | 正常 | code, stopped, i24, hall 等 5 路 · 附件 4 | 电流环第2条重采：窗口 32 毫秒，d 轴阶跃 6 个刻度落在记录里 | `20261015T051355Z_307f` |
| 13:11 | 采集 | 正常 | code, stopped, i24, hall 等 5 路 · 附件 4 | 电流环第2条：200毫安 q 轴慢转时，d 轴阶跃 6 个刻度 | `20261015T051118Z_e2d5` |
| 12:10 | 采集 | 正常 | edge_cycles, steady_common, steady_min, steady_floor 等 11 路 | Hall change is a table load and the trace body runs only on the store tick. Confirm the long tick came down on a 200 mA spin. | `20261015T041035Z_1a92` |
| 12:10 | 采集 | 正常 | code, stopped, i24, hall 等 5 路 · 附件 1 | 当前固件的 200 mA 转动，确认整拍最长周期 | `20261015T041011Z_8d17` |
| 12:06 | 采集 | 正常 | code, stopped, i24, hall 等 5 路 · 附件 1 | 换边不再同时存轨迹之后的 200 mA 转动，用来读整拍最长周期 | `20261015T040632Z_4708` |
| 12:03 | 采集 | 正常 | code, stopped, i24, hall 等 5 路 · 附件 1 | 固定换边和轨迹闸门之后的 200 mA 转动，用来读整拍最长周期 | `20261015T040347Z_28df` |
| 12:03 | 采集 | 正常 | edge_cycles, steady_min, steady_common, steady_max 等 7 路 | Hall edge is a fixed table load and trace runs only on the store tick. Stub of 32 current-loop ticks, bridge off. | `20261015T040325Z_a859` |
| 11:53 | 采集 | 正常 | code, stopped, i24, hall 等 5 路 · 附件 1 | 分段计一拍周期：保护、交接、电流环、六步 | `20261015T035316Z_ce9d` |
| 11:18 | 采集 | 正常 | id_mean_lsb, iq_mean_lsb, elec_revs, park_off_q16 等 13 路 | 核对实测扇区宽度进入角度之后，200毫安慢转的 d 轴是否还在 1 个刻度内 | `20261015T031821Z_a06b` |
| 11:17 | 采集 | 正常 | code, stopped, i24, hall 等 5 路 · 附件 1 | 实测扇区宽度进角度之后，200毫安慢转核对 d 轴均值 | `20261015T031748Z_406f` |
| 11:12 | 采集 | 正常 | code, stopped, i24, hall 等 5 路 · 附件 1 | 200毫安慢转，采新楼梯索引下六个扇区停留的近期平均 | `20261015T031215Z_30df` |
| 11:11 | 采集 | 正常 | edge_cycles, steady_min, steady_common, steady_max 等 8 路 | 核对扇区停留平均加进边界之后的一拍周期 | `20261015T031123Z_9fdf` |
| 10:49 | 采集 | 正常 | dwell0, dwell1, dwell2, dwell3 等 10 路 | 判断新楼梯索引下的一圈扇区停留能不能写进宽度表 | `20261015T024906Z_5638` |
| 10:48 | 采集 | 正常 | ocp_kind, ocp_phase, ocp_lsb, ocp_lsb_abs 等 10 路 | 记下六步阶段 V 相软件过流，桥已关，没有再次启动 | `20261015T024854Z_cfe5` |
| 10:47 | 采集 | 正常 | code, stopped, i24 | 200毫安、2毫秒采样，平均新楼梯索引下的扇区停留 | `20261015T024702Z_78ce` |
| 10:40 | 采集 | 正常 | code, stopped, i24, hall 等 5 路 · 附件 1 | 200毫安慢转，重测新楼梯索引下六个扇区的停留拍数 | `20261015T024056Z_34b8` |
| 10:38 | 采集 | 正常 | code, stopped, i24, hall 等 5 路 · 附件 1 | 慢转重测新楼梯索引下六个扇区的停留拍数 | `20261015T023830Z_00e3` |

### 2026-10-14

| 时间 | 类型 | 结论 | 摘要 | 目的 | 记录 |
|---|---|---|---|---|---|
| 18:37 | 采集 | 正常 | tick_cyc_edge, tick_cyc_min, tick_cyc_max, tick_cyc_cluster 等 6 路 · stm32f030-tick | Remeasure the current-loop hall edge after the review code fixes. Edge 1699 cycles, steady minimum 1210. Bridge stayed off. | `20261014T103713Z_e471` |
| 18:11 | 采集 | 正常 | tick_cyc_edge, tick_cyc_min, tick_cyc_max, angle_edge_cyc 等 7 路 · stm32f030-tick | Remove Newton from the hall-edge divide. Forced current-loop edge dropped from 1811 to 1671 cycles. Steady ticks min 1200. Bridge stayed off. | `20261014T101151Z_811c` |
| 17:47 | 采集 | 正常 | tick_cyc_max, tick_cyc_min, tick_cyc_edge, tick_cyc_steady 等 6 路 · stm32f030-tick | Confirm whether a current-loop hall-edge tick can exceed 2400 cycles. Forced edge measured 1811, steady interpolating ticks 1206 to 1220, bridge stayed off. | `20261014T094740Z_1446` |
| 17:25 | 采集 | 正常 | id_mean_lsb, iq_mean_lsb, n_points, hall 等 12 路 | 复跑静止、iq 0 的电流环窗，并把清零之后的最长一拍算作电流环自己的。 | `20261014T092534Z_0dba` |
| 17:24 | 采集 | 正常 | code, stopped, i24, hall 等 5 路 · 附件 1 | 复跑完成标准第1条：转子静止、iq 0；并把六步和电流环的最长一拍分开 | `20261014T092418Z_4c3c` |
| 17:18 | 采集 | 正常 | tick_overrun, tick_total, tick_cyc_max, tick_cyc_avg 等 9 路 | 新固件第一次起转进电流环时的节拍诊断：超时次数、最长一拍、平均，以及电流环窗里的 id/iq 均值。 | `20261014T091801Z_a12f` |
| 17:16 | 采集 | 正常 | code, stopped, i24, hall 等 5 路 · 附件 1 | 新固件（常见拍 1167）第一次起转：10% 六步交接到电流环，iq 0，看读状态、节拍超时和最长一拍 | `20261014T091617Z_3436` |
| 16:53 | 采集 | 正常 | tick_cyc_min, tick_cyc_max, tick_cyc_common | Whole-tick cycles after packing hall state and removing the unread direction store, 24 V on, bridge off. | `20261014T085345Z_6756` |
| 16:51 | 采集 | 正常 | tick_cyc_min, tick_cyc_max, tick_cyc_common | Whole-tick cycles after splitting the current PI into several calls, 24 V on, bridge off. | `20261014T085128Z_188c` |
| 15:47 | 采集 | 正常 | tick_cyc_min, tick_cyc_max, tick_cyc_common | Whole-tick cycle count of the handover current loop after the straight-line tick, with 24 V off and the bridge disabled. | `20261014T074756Z_b5e9` |
| 14:36 | 采集 | 正常 | tick_first, tick_min, tick_max_later, tick_common 等 5 路 | Measure the whole current-loop tick in clock cycles, with the 24 V bus off and the bridge disabled. | `20261014T063627Z_404e` |
| 14:29 | 采集 | 正常 | div1_cyc, div2_cyc, pow2_cyc, q_1000 等 5 路 | Time the reciprocal divider that replaces libgcc division on the current-loop tick, with the 24 V bus off and the bridge disabled. | `20261014T062902Z_19ce` |
| 13:21 | 采集 | 正常 | seg0, seg1, seg2, seg3 等 8 路 · 附件 1 | 用查表和缓存缩短电流环之后，再量整拍还剩多少周期 | `20261014T052142Z_6a75` |
| 12:56 | 采集 | 正常 | seg0, seg1, seg2, seg3 等 8 路 · 附件 1 | 把电流环一步拆成四段，看 2300 周期耗在哪 | `20261014T045616Z_ce91` |
| 12:29 | 采集 | 正常 | seg0, seg1, seg2, seg3 等 8 路 · 附件 1 | 确认跳过六步里的电压计算之后，电流环本身还要多少周期 | `20261014T042944Z_897c` |
| 12:27 | 采集 | 正常 | seg0, seg1, seg2, seg3 等 8 路 · 附件 1 | 六步期间量四段耗时，确认整拍超过 50 微秒导致看门狗复位 | `20261014T042725Z_4183` |
| 12:04 | 采集 | 正常 | win_a_ok, win_b_ok, win_c_ok, win_a_fail 等 11 路 · 附件 1 | Check whether one-byte status reads succeed after the I2C slave is allowed to stretch the clock, with the tick stopped, with a short tick, and with the current-loop code running. | `20261014T040448Z_ee4e` |
| 11:16 | 采集 | 正常 | tick_off_ok, tick_off_fail, light_tick_avg, light_tick_ok 等 9 路 · 附件 1 | Compare one-byte status reads with the 50 us tick stopped, with a short tick, and with the current-loop tick, all with the bridge off. | `20261014T031633Z_f62e` |
| 11:10 | 采集 | 正常 | reads_ok, reads_fail, avg_tick, window_overrun_delta 等 10 路 · 附件 1 | Repeat the one-byte status read after the current loop is steady, on the NOSTRETCH firmware, to see if the read still fails when the tick is about 2300 cycles. | `20261014T031030Z_fcd7` |
| 10:50 | 采集 | 正常 | reads_ok, reads_fail, rtt_min_ms, rtt_max_ms 等 10 路 · 附件 1 | See whether a one-byte status read completes while the bridge switches at a fixed common-mode duty and the rotor stays still. | `20261014T025008Z_ce87` |
| 10:16 | 采集 | 正常 | six_state, six_mode, six_cyc_max, six_overrun 等 8 路 | 桥已开、节拍还轻时读一个字节。发出时最长 1520、超时 0，这个字节没有在六步结束前读完 | `20261014T021625Z_91e9` |
| 10:08 | 采集 | 正常 | six_cyc_max, six_overrun, six_state, six_mode 等 8 路 | 想在六步阶段读状态，但这次读跨过了交接，不能用来区分原因 | `20261014T020814Z_17b7` |
| 03:06 | 采集 | 正常 | state_max, stat_ok, stat_n, i24 等 5 路 | I2C 从机改成允许拉低时钟后，起转进电流环再读 10 次状态，看还失不失败 | `20261013T190632Z_4e42` |
| 02:54 | 采集 | 正常 | avg_cyc, steady_max_cyc, burst_max_cyc, overrun 等 9 路 | 电流环稳态节拍约 2178，最长约 2192，10 次读状态全部失败 | `20261013T185441Z_cb7f` |
| 02:22 | 采集 | 正常 | state_max, mode_max, hall_edges, fault 等 10 路 | 10% 起转时用调试口看状态。进了电流环，但 mot stat 回复是 FAIL | `20261013T182249Z_2f79` |
| 01:57 | 采集 | 正常 | hall6-2_hall_raw, hall6-2_step, hall6-2_ticks_since_edge, hall6-2_kick 等 8 路 · 附件 1 | 自举没结束时踢腿不再跳步。10% 起转第一次换相在 39 毫秒，霍尔按 5、4、6、2、3、1 走，没有过流 | `20261013T175755Z_3174` |
| 01:56 | 采集 | 正常 | code, stopped, i24 | 自举没结束时不再跳过踢腿第一步，再看 10% 起转 | `20261013T175632Z_f214` |
| 01:56 | 采集 | 正常 | hall6-1_hall_raw, hall6-1_step, hall6-1_ticks_since_edge, hall6-1_kick 等 9 路 · 附件 1 | 10% 起转的霍尔迹：第一步在 59 毫秒才出现，而且是第 2 步，第 1 步被自举窗口吞掉 | `20261013T175605Z_5211` |
| 01:54 | 采集 | 正常 | code, stopped, i24 | 起转前武装 hall6 迹，看踢腿第一步是不是落在自举窗口里 | `20261013T175418Z_20c5` |
| 01:43 | 采集 | 正常 | code, flt, phase, i_lsb 等 14 路 | 10% 起转，零点已减掉。六步还没交到电流环就软件过流，桥被锁住 | `20261013T174338Z_48fb` |
| 01:41 | 采集 | 正常 | code, stopped, i24 | 零点已减掉，节拍在起转前保持关闭，10% 交接进电流环，iq 指令 0 | `20261013T174145Z_bc34` |
| 01:36 | 采集 | 正常 | code, stopped, i24 | 零点已减掉后，10% 六步交接进电流环，iq 指令 0 | `20261013T173604Z_2fbf` |
| 01:27 | 采集 | 正常 | ready, zero_u, zero_v, zero_w 等 9 路 | 零点采集放在电机节拍里，空闲时节拍没开，所以没有采到，没有起转 | `20261013T172713Z_4856` |
| 01:19 | 采集 | 正常 | a1_overrun, a1_ticks, a1_avg_cyc, a1_max_cyc 等 15 路 | I2C 中断改到电机节拍下面之后，不开桥三窗看读状态还会不会撑过 50 微秒 | `20261013T171934Z_1680` |
| 01:09 | 采集 | 正常 | a1_overrun, a1_avg_cyc, a1_max_cyc, b_overrun 等 11 路 | 读状态的计算已离开 I2C 中断后，不开桥三窗看节拍是否还被撑过 50 微秒 | `20261013T170927Z_d260` |
| 01:09 | 采集 | 正常 | ocp_hold, ocp_kind, moe, i24 等 6 路 | 软件过流后锁住桥：强制跳闸，读状态不得重新送电 | `20261013T170926Z_57f0` |

### 2026-10-13

| 时间 | 类型 | 结论 | 摘要 | 目的 | 记录 |
|---|---|---|---|---|---|
| 23:44 | 采集 | 正常 | code, stopped, i24 | 完成标准第1条：观察用累加已关，10% | `20261013T154438Z_7f15` |
| 15:27 | 采集 | 正常 | code, stopped, i24 | 抓看门狗复位原因：10%，诊断记录含节拍差值 | `20261013T072736Z_8b53` |
| 14:39 | 采集 | 正常 | code, stopped, i24 | 完成标准第1条：10% 重跑；上次电流环接手后单片机复位，跑前已清复位标志 | `20261013T063925Z_93cd` |
| 14:10 | 采集 | 正常 | code, stopped, i24 | 完成标准第1条：起转占空比改为10%后，转子静止、q轴指令0，看 id 和 iq 平均 | `20261013T061017Z_a10f` |
| 13:30 | 采集 | 正常 | code, stopped, i24 | 完成标准第1条重试：vsweep 六组正常后，转子静止、q轴指令0，看 id 和 iq 平均 | `20261013T053041Z_be04` |
| 13:26 | 采集 | 正常 | code, state, hall, hall_begin 等 6 路 · 附件 1 | 起转在霍尔2报堵转后，静止扫六组上下管，重点看第二块板下管（U→V、W→V） | `20261013T052626Z_58b6` |
| 13:19 | 采集 | 正常 | code, stopped, i24 | 完成标准第1条：转子静止、q轴指令0，看 id 和 iq 平均 | `20261013T051942Z_e02f` |
| 12:43 | 采集 | 正常 | i_b3_80, i_b3_120, i_b3_160, i_b1_80 等 9 路 | 换第三块板 UCC27211 后复测。固定脉宽保持，回路：3 用第1块下管，1/2 用第3块下管。CCR 80/120/160 期望 0.025/0.091/0.197 A。 | `20261013T044339Z_82f3` |
| 12:01 | 采集 | 正常 | i_b2_80, i_b2_120, i_b2_160, i_b1_80 等 9 路 | 换第二块板 UCC27211 后，排线已恢复。固定脉宽保持，回路：1/2 用第3块下管，3 用第1块下管。CCR 80/120/160 期望 0.025/0.091/0.197 A。 | `20261013T040102Z_f66a` |
| 01:24 | 采集 | 正常 | ipwm080, ipwm0120, ipwm0160, ipwm180 等 7 路 | 第一、二块板排线对调后，两路 PWM 对第三相下管的母线电流 | `20261012T172436Z_b640` |
| 01:11 | 采集 | 正常 | iU80, iU120, iU160, iV80 等 10 路 | 三块板 HIN 都加 220pF 后，三相高边分别开通的母线电流 | `20261012T171136Z_49c1` |

### 2026-10-12

| 时间 | 类型 | 结论 | 摘要 | 目的 | 记录 |
|---|---|---|---|---|---|
| 16:47 | 采集 | 正常 | i48b, i80b, i120b, i160b 等 5 路 | HIN 加 220pF 后复测 CCR 48/80/120/160 母线电流 | `20261012T084754Z_93b6` |
| 16:44 | 采集 | 正常 | i48, i80, i120, i160 等 5 路 | 第一块板 HIN 对 GND 加 220pF 后，无示波器，CCR 48/80/120/160 母线电流 | `20261012T084450Z_6761` |
| 15:30 | 采集 | 正常 | i160, iend | CH2 接回第三相 VOUT 且地夹悬空，CCR160 | `20261012T073058Z_6128` |
| 15:28 | 采集 | 正常 | i160, iend | 再次测 CCR160 第一相第三相下管的母线电流 | `20261012T072829Z_4d8e` |
| 15:12 | 采集 | 正常 | i160, iend | CH2 探针离开 HIN 后，CCR160 母线电流仍为满值 | `20261012T071253Z_c973` |
| 15:10 | 采集 | 正常 | i160, iend | CH2 探针离开 HIN 后，CCR160 第一相第三相下管的母线电流 | `20261012T071005Z_d35e` |
| 14:56 | 采集 | 正常 | i160, iend, hin_n, full · 附件 1 | CH1 第一相 VOUT、CH2 第一块板 HIN，CCR160，1.2ms 高分辨率 | `20261012T065603Z_472a` |
| 12:58 | 采集 | 正常 | i160, iend, pulse · 附件 1 | 恢复 CH1 地夹、去掉 CH2 地夹，CCR160 两相 VOUT | `20261012T045817Z_687a` |
| 12:47 | 采集 | 正常 | i160, iend, pulse · 附件 1 | 去掉 CH1 地夹，CH2 地夹仍在，CCR160 两相 VOUT | `20261012T044752Z_42fb` |
| 12:03 | 采集 | 正常 | i160, iend, pulse · 附件 1 | 第1步：坏状态下第一相和第三相 VOUT，CCR160 | `20261012T040346Z_e8c3` |
| 11:40 | 采集 | 正常 | i160, iend | CH2 地夹再换位置后，CCR160 第一相第三相下管的母线电流 | `20261012T034013Z_4ee2` |
| 11:39 | 采集 | 正常 | i160, iend | CH2 地夹再换位置后，CCR160 第一相第三相下管的母线电流 | `20261012T033905Z_1e02` |
| 11:37 | 采集 | 正常 | i160, iend | CH2 地夹换位置后，CCR160 第一相第三相下管的母线电流 | `20261012T033746Z_acd8` |
| 11:34 | 采集 | 正常 | i160, iend | CH2 地夹换位置后，CCR160 第一相第三相下管的母线电流 | `20261012T033410Z_1619` |
| 11:31 | 采集 | 正常 | i160, iend | 重新接上示波器 CH2 后，CCR160 第一相第三相下管的母线电流 | `20261012T033128Z_d5cb` |
| 11:28 | 采集 | 正常 | i160, iend | 改地线并拆除示波器后，CCR160 第一相第三相下管的母线电流 | `20261012T032836Z_b03e` |
| 02:01 | 采集 | 正常 | i160, iend | 确认两地夹连通后只接 CH1、断开 CH2，CCR160 第一相第三相下管的母线电流 | `20261011T180118Z_c176` |
| 01:31 | 采集 | 正常 | i160, iend | 只拔掉 CH1 地夹，CH2 地夹仍在，CCR160 第一相第三相下管的母线电流 | `20261011T173138Z_3199` |
| 01:30 | 采集 | 正常 | i160, iend | 只拔掉 CH2 地夹，CH1 地夹仍在，CCR160 第一相第三相下管的母线电流 | `20261011T173016Z_9b08` |
| 01:15 | 采集 | 正常 | i160, iend | 两只示波器地夹重新接上后，CCR160 第一相第三相下管的母线电流 | `20261011T171527Z_157a` |
| 01:12 | 采集 | 正常 | i160, iend | 拔掉两个示波器地夹后，CCR160 第一相第三相下管的母线电流 | `20261011T171243Z_cd8b` |
| 00:56 | 采集 | 正常 | i160e, iende, vgs, vout · 附件 1 | CCR160 5us/格 栅极与 VOUT | `20261011T165639Z_492b` |
| 00:51 | 采集 | 正常 | i160, iend, vgs, vout · 附件 3 | CCR160 第一相，示波器看 Q1 栅极对地和 VOUT 对地，探头 10 倍 | `20261011T165156Z_18ce` |

### 2026-10-11

| 时间 | 类型 | 结论 | 摘要 | 目的 | 记录 |
|---|---|---|---|---|---|
| 23:56 | 采集 | 正常 | i80, i120, i160, iend | V_BOOST 外供 32V 后，静止相间窄脉冲的母线电流是否回到计算值 | `20261011T155631Z_053c` |
| 16:17 | 采集 | 正常 | p0l2, p1l2, p2l0, p2l1 | 12 伏、80 计数，三块半桥分别做开关相，看短脉冲下高边是否还能输出 | `20261011T081741Z_96e0` |
| 16:10 | 采集 | 正常 | pwm0_low2, pwm1_low2, pwm2_low0 | 12 伏下三块半桥轮流做 160 计数的开关相，比较母线电流，区分共性问题还是单板问题 | `20261011T081007Z_5eee` |
| 15:38 | 采集 | 正常 | i48, i80, i120, i160 | 母线 12 伏，自举先充后第一相 48/80/120/160 计数、第三相拉低，看母线电流 | `20261011T073803Z_a082` |
| 15:35 | 采集 | 正常 | i48, i80, i120, i160 | 母线降到 6 伏，自举先充后第一相 48/80/120/160 计数、第三相拉低，看母线电流 | `20261011T073540Z_b415` |
| 15:34 | 采集 | 正常 | i48, i100, i150, i200 | 母线降到 6 伏，自举先充后，第一相加脉宽、第三相拉低，看母线电流是否按 1.3 欧的预期上升 | `20261011T073458Z_db49` |
| 15:30 | 采集 | 正常 | i48, i60, i80 | 母线改到 12 伏后，第一相 48、60、80 个计数、第三相拉低，看母线电流 | `20261011T073055Z_729a` |
| 15:28 | 采集 | 正常 | i48, i60 | 自举先充 40 毫秒后，第一相脉宽 48 和 60 个计数、第三相拉低，看 24 伏母线电流 | `20261011T072829Z_e21e` |
| 14:18 | 采集 | 正常 | v | 万用表量第一块半桥 V_PWR 对 GND | `20261011T061843Z_eef4` |
| 14:17 | 采集 | 正常 | v_pwr | 万用表量第一块半桥 J1 的 V_PWR 对 GND | `20261011T061702Z_3ae9` |
| 14:07 | 采集 | 正常 | v, ccr, i24 | 万用表量第一根和第三根，80 计数 | `20261011T060701Z_97f4` |
| 13:54 | 采集 | 正常 | v, ccr, i24 | 万用表量第一根和第三根，48 计数 | `20261011T055402Z_0d1b` |
| 13:22 | 采集 | 正常 | code, state, hall, hall_begin 等 6 路 · 附件 1 | 静止扫电压，死区补偿关闭，看各相指令电压和相电流是否成正比 | `20261011T052247Z_13ce` |
| 13:21 | 采集 | 正常 | code, state, i24 | 静止扫电压，死区补偿关闭，看各相指令电压和相电流是否成正比 | `20261011T052158Z_66a2` |
| 13:17 | 采集 | 正常 | code, state, i24 | 静止扫电压，死区补偿关闭，看各相指令电压和相电流是否成正比 | `20261011T051721Z_e1b1` |
