zhang1career/tars-motor-ctrl/pcb/mainboard/models/INDEX.md

# benchgate 记录目录

> 由 benchgate 自动生成，请勿手改。源数据：`models/index.jsonl`，共 42 条。生成于 2026-10-20 12:53。

## 当前状态

没有仿真或 gate 记录。

| 类型 | 最近一次 | 结论 | 输入 | 摘要 | 记录 |
|---|---|---|---|---|---|
| 采集 | 2026-10-20 12:53 | 有空通道 | — | scope_ch1 · 空通道 1 | `20261020T045302Z_822d` |

## 记录（最新在前，最多 300 条）

### 2026-10-20

| 时间 | 类型 | 结论 | 摘要 | 目的 | 记录 |
|---|---|---|---|---|---|
| 12:53 | 采集 | 有空通道 | scope_ch1 · 空通道 1 | User reports low-freq V_BOOST wobble; capture CH4 for software loop tuning. | `20261020T045302Z_822d` |

### 2026-10-19

| 时间 | 类型 | 结论 | 摘要 | 目的 | 记录 |
|---|---|---|---|---|---|
| 23:34 | 采集 | 正常 | vavg · 附件 1 | FOC B2 停转 nFAULT after UCC27211; CH4 | `20261019T153433Z_e0ed` |
| 23:34 | 采集 | 正常 | vavg · 附件 1 | FOC B2 停转 W after UCC27211; CH3 | `20261019T153430Z_3235` |
| 23:34 | 采集 | 正常 | vavg · 附件 1 | FOC B2 停转 V after UCC27211; CH2 | `20261019T153426Z_aea2` |
| 23:34 | 采集 | 正常 | vavg · 附件 1 | FOC B2 停转 U TP14 after UCC27211; CH1 | `20261019T153423Z_20f7` |
| 23:18 | 采集 | 正常 | scope_ch1 | B2 run scope CH4 after U driver replace | `20261019T151820Z_2448` |
| 23:18 | 采集 | 正常 | scope_ch1 | B2 run scope CH3 after U driver replace | `20261019T151818Z_2aab` |
| 23:18 | 采集 | 正常 | scope_ch1 | B2 run scope CH2 after U driver replace | `20261019T151815Z_ea83` |
| 23:18 | 采集 | 正常 | scope_ch1 | B2 run scope CH1 after U driver replace | `20261019T151813Z_9096` |
| 23:14 | 采集 | 正常 | scope_ch1 | B2 run scope CH4 after U driver fix | `20261019T151440Z_13e9` |
| 23:14 | 采集 | 正常 | scope_ch1 | B2 run scope CH3 after U driver fix | `20261019T151437Z_9f9d` |
| 23:14 | 采集 | 正常 | scope_ch1 | B2 run scope CH2 after U driver fix | `20261019T151435Z_53e8` |
| 23:14 | 采集 | 正常 | scope_ch1 | B2 run scope CH1 after U driver fix | `20261019T151432Z_30c3` |
| 23:14 | 采集 | 正常 | scope_ch1 | U driver fix stop baseline CH4 | `20261019T151407Z_c3b0` |
| 23:14 | 采集 | 正常 | scope_ch1 | U driver fix stop baseline CH3 | `20261019T151404Z_aef5` |
| 23:14 | 采集 | 正常 | scope_ch1 | U driver fix stop baseline CH2 | `20261019T151402Z_d255` |
| 23:13 | 采集 | 正常 | scope_ch1 | U driver fix stop baseline CH1 | `20261019T151359Z_f944` |
| 23:13 | 采集 | 有空通道 | scope_ch1 · 空通道 1 |  | `20261019T151312Z_d0a7` |
| 16:59 | 采集 | 正常 | scope_ch1 | stopped baseline phase amp CH3 | `20261019T085953Z_6056` |
| 16:59 | 采集 | 正常 | scope_ch1 | stopped baseline phase amp CH2 | `20261019T085950Z_f96c` |
| 16:59 | 采集 | 正常 | scope_ch1 | stopped baseline phase amp CH1 | `20261019T085947Z_b3a8` |
| 16:52 | 采集 | 正常 | scope_ch1 | 200mA torque TP19 nFAULT | `20261019T085209Z_e0ff` |
| 16:52 | 采集 | 正常 | scope_ch1 | 200mA torque W amp | `20261019T085205Z_da24` |
| 16:52 | 采集 | 正常 | scope_ch1 | 200mA torque V amp | `20261019T085201Z_0200` |
| 16:51 | 采集 | 正常 | scope_ch1 | 200mA torque U amp | `20261019T085157Z_5daf` |
| 14:55 | 采集 | 有空通道 | scope_ch1 · 空通道 1 | V amp during hall6 | `20261019T065535Z_5131` |
| 14:53 | 采集 | 正常 | scope_ch1 | U amp during hall6 start | `20261019T065339Z_81b6` |
| 14:01 | 采集 | 正常 | scope_ch1 | 停转，20微秒/格，TP19 nFAULT | `20261019T060118Z_114b` |
| 14:01 | 采集 | 正常 | scope_ch1 | 停转，20微秒/格，W相放大器输出 | `20261019T060115Z_f490` |
| 14:01 | 采集 | 正常 | scope_ch1 | 停转，20微秒/格，V相放大器输出 | `20261019T060113Z_f7a2` |
| 14:01 | 采集 | 正常 | scope_ch1 | 停转，20微秒/格，U相放大器输出 | `20261019T060110Z_3449` |
| 13:53 | 采集 | 正常 | scope_ch1 | 停转时按正确换算重读 U 相放大器输出 | `20261019T055315Z_9e24` |
| 13:52 | 采集 | 正常 | scope_ch1 | 停转时重读 U 相放大器，空内存则自由运行再读 | `20261019T055216Z_95de` |
| 13:51 | 采集 | 有空通道 | scope_ch1 · 空通道 1 | 停转时读 U 相放大器，带上刻度和偏移 | `20261019T055124Z_fdf3` |
| 13:50 | 采集 | 正常 | scope_ch1 | 停转时自由运行读取 U 相放大器输出，避免单次触发空内存 | `20261019T055028Z_9179` |
| 13:40 | 采集 | 有空通道 | scope_ch1 · 空通道 1 | 清掉 VISA 锁之后，停转时确认示波器能连上并读出 CH1 | `20261019T054032Z_43b7` |

### 2026-10-17

| 时间 | 类型 | 结论 | 摘要 | 目的 | 记录 |
|---|---|---|---|---|---|
| 22:58 | 采集 | 正常 | vboost-slow_v_v, vboost-fast_v_v · 附件 2 | 用 CH1 波形算 V_BOOST 是否到 32V、是否高过高边漏极 | `20261017T145816Z_c073` |
| 22:13 | 采集 | 正常 | vboost-ch1_vboost_ch1_v · 附件 1 | 补上 V_BOOST 的 CH1 波形，替代空通道那次采集 | `20261017T141331Z_f1f1` |
| 22:09 | 采集 | 正常 | scope_ch1_avg, scope_ch1_max, scope_ch1_min, pa4_raw 等 6 路 | 转动时对一下示波器 CH1 和升压反馈，看 V_BOOST 有没有到 32V | `20261017T140919Z_d573` |
| 22:05 | 采集 | 有空通道 | scope_ch1 · 空通道 1 | 电机停转时看 V_BOOST 是否到 32V，以便和高边漏极比较 | `20261017T140525Z_8bfb` |
| 15:00 | 采集 | 有空通道 | scope_ch1 · 空通道 1 · V_BOOST | Scope is DC coupled, 10 V/div, 10X, free-running. Capture V_BOOST to read the level and the ripple the screen can resolve. | `20261017T070007Z_b06f` |
| 14:52 | 采集 | 有空通道 | scope_ch1 · 空通道 1 · V_BOOST | CH1 probe is 10X on V_BOOST. Capture the boost output ripple while it regulates and the motor bridge stays off. | `20261017T065257Z_c37d` |
