zhang1career/tars-motor-ctrl/pcb/mainboard/motor-ctrl-mainboard.kicad_pcb

## KiCad design pcb/mainboard/motor-ctrl-mainboard.kicad_pcb (2026-10-15)

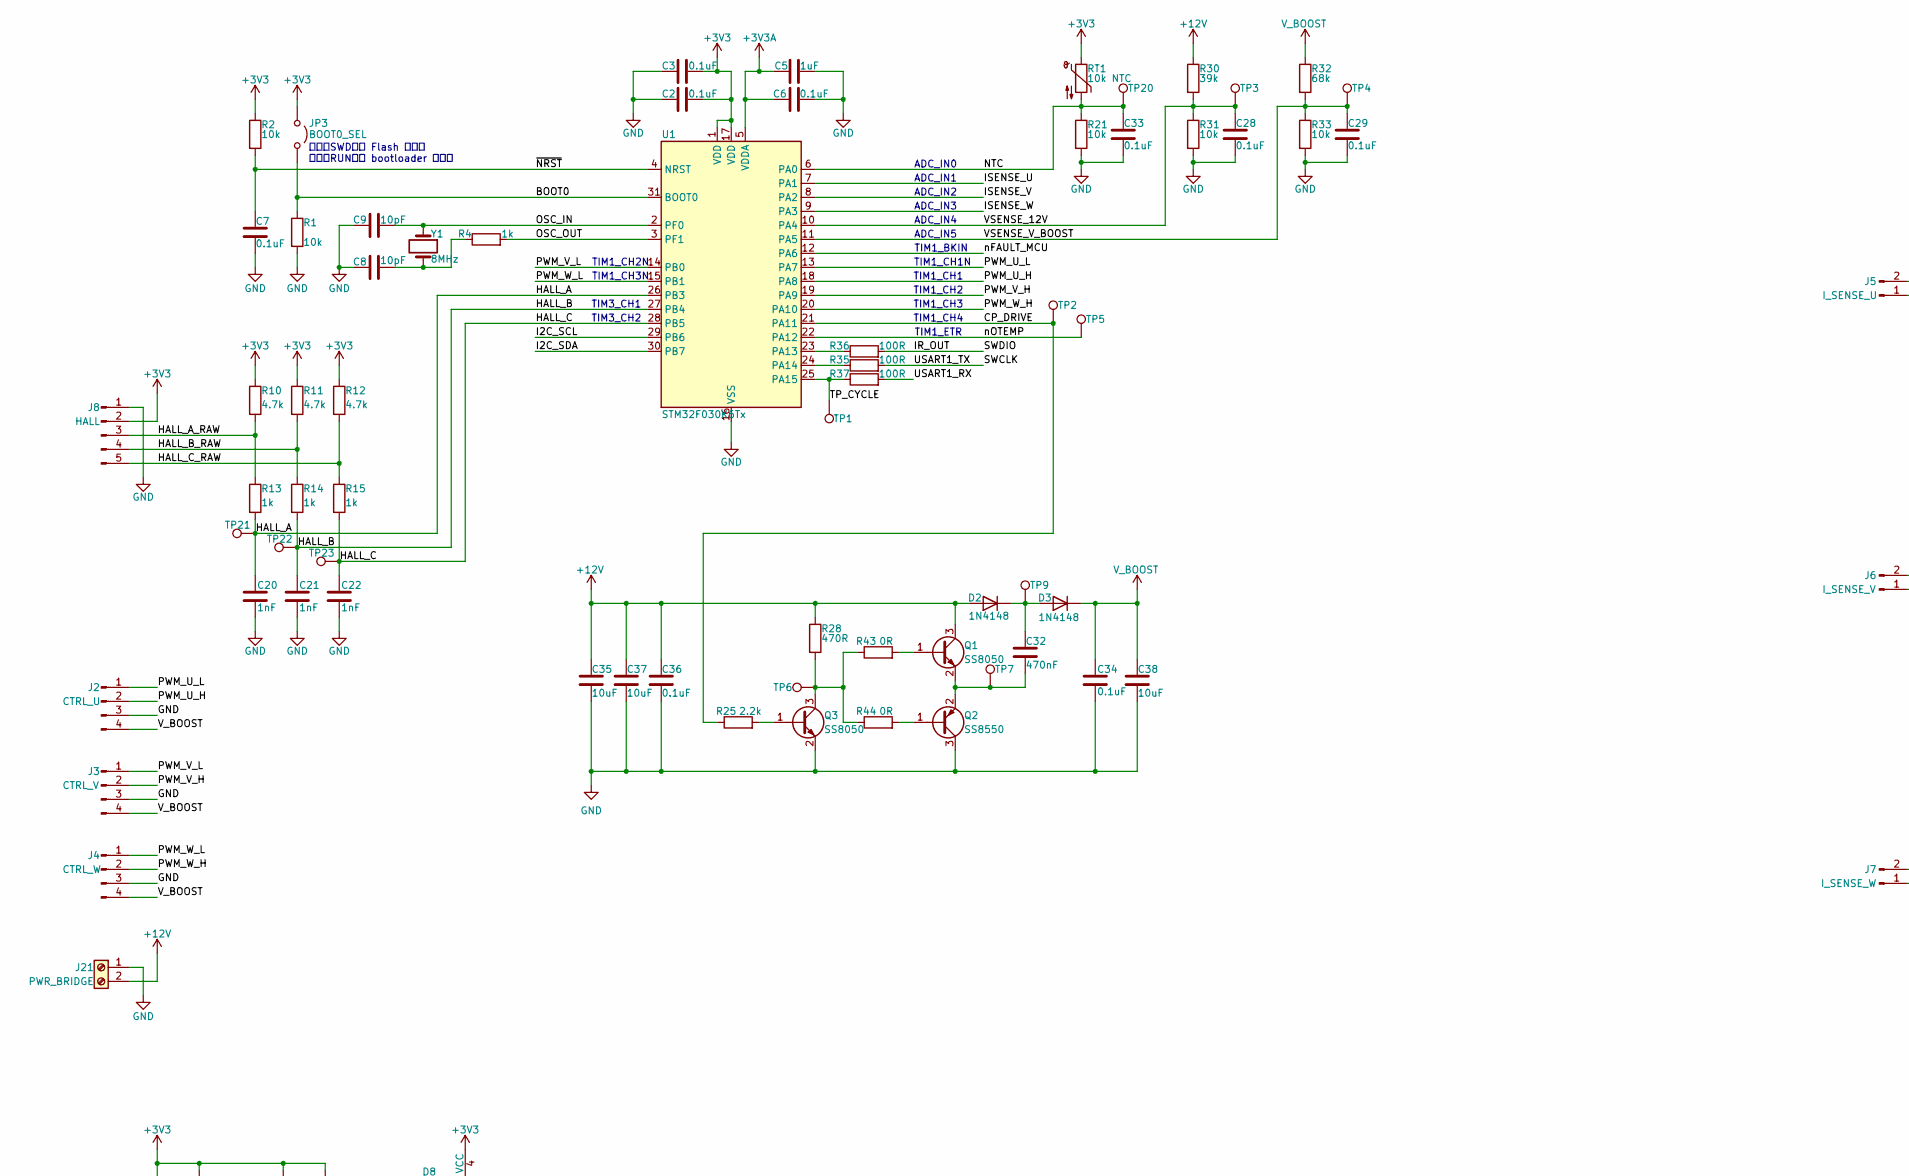
[picture p1: schematic motor-ctrl-mainboard.kicad_sch, part in row 1, column 1]

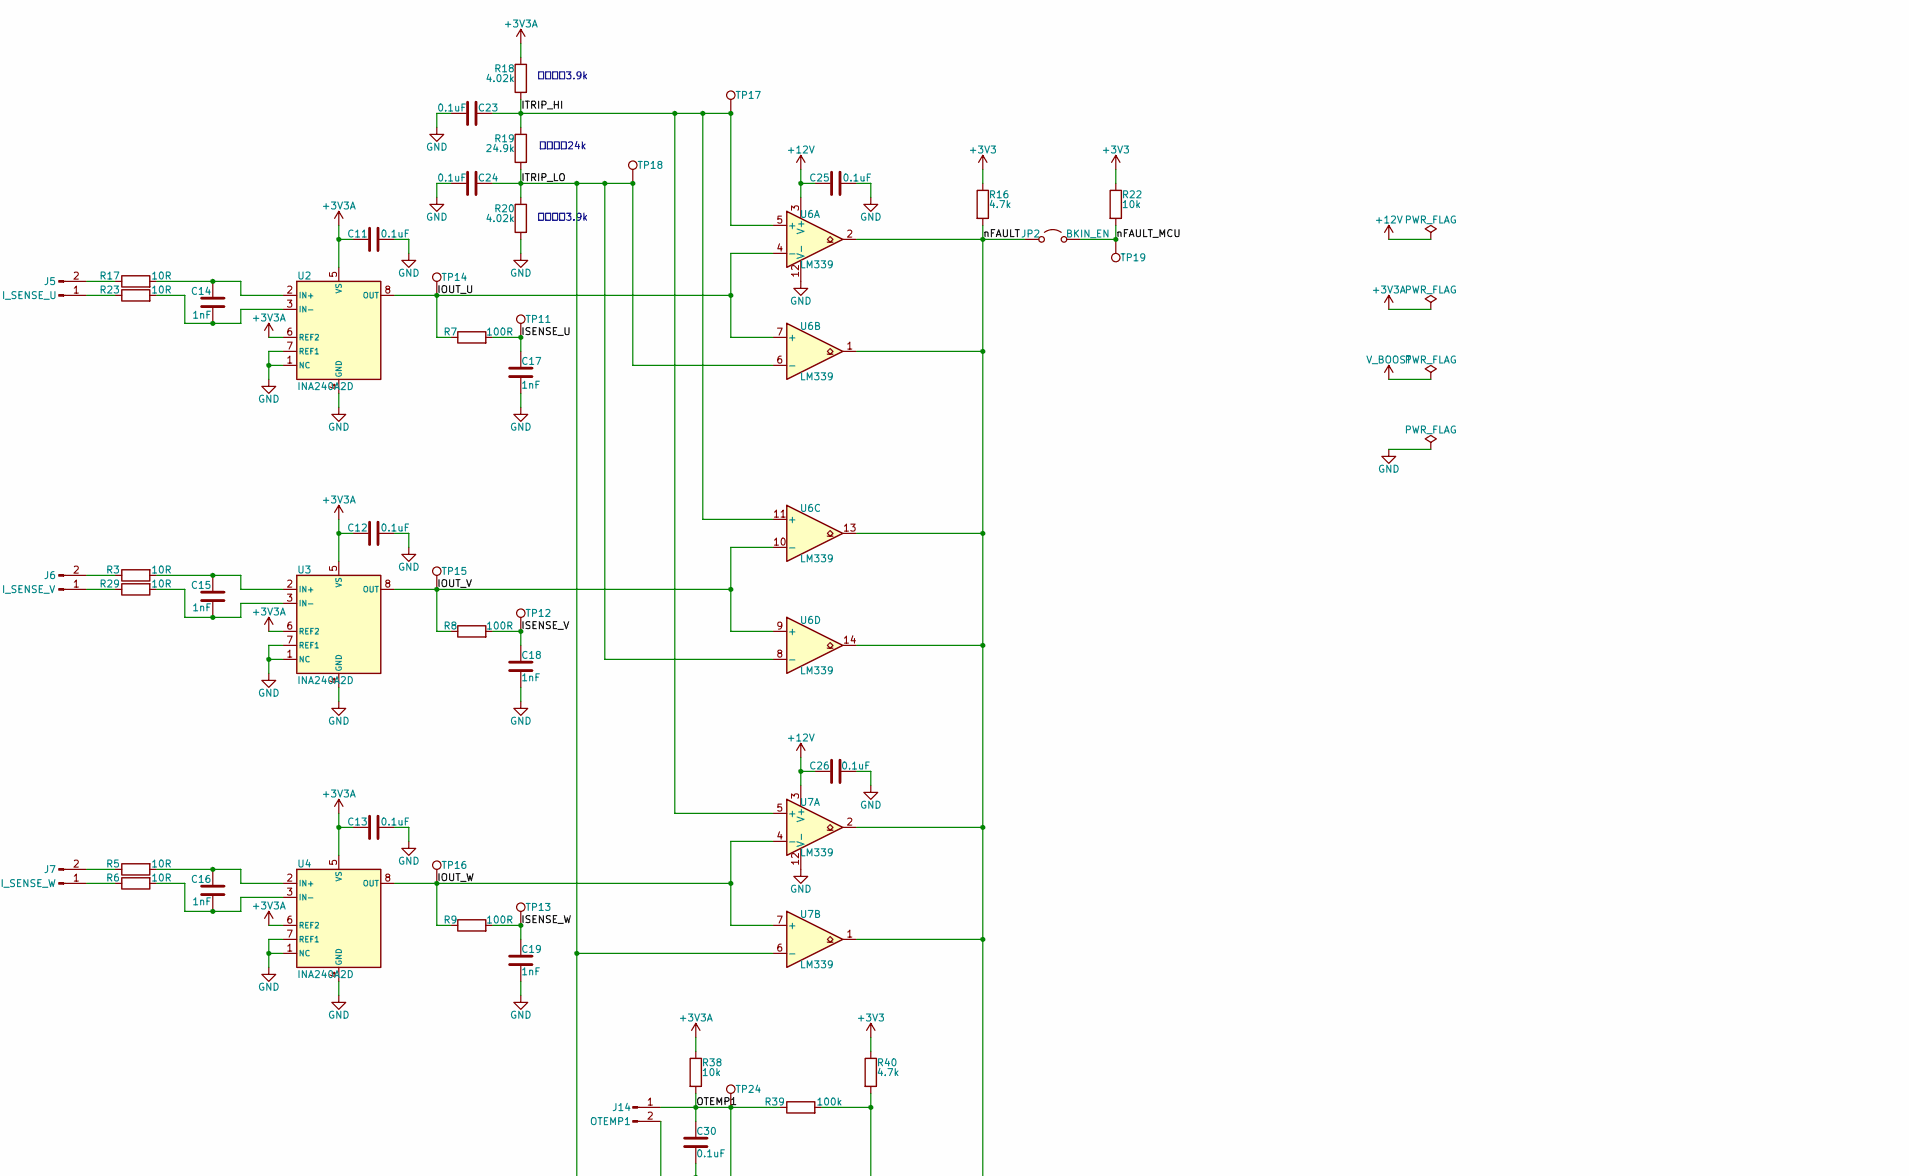
[picture p2: schematic motor-ctrl-mainboard.kicad_sch, part in row 1, column 2]

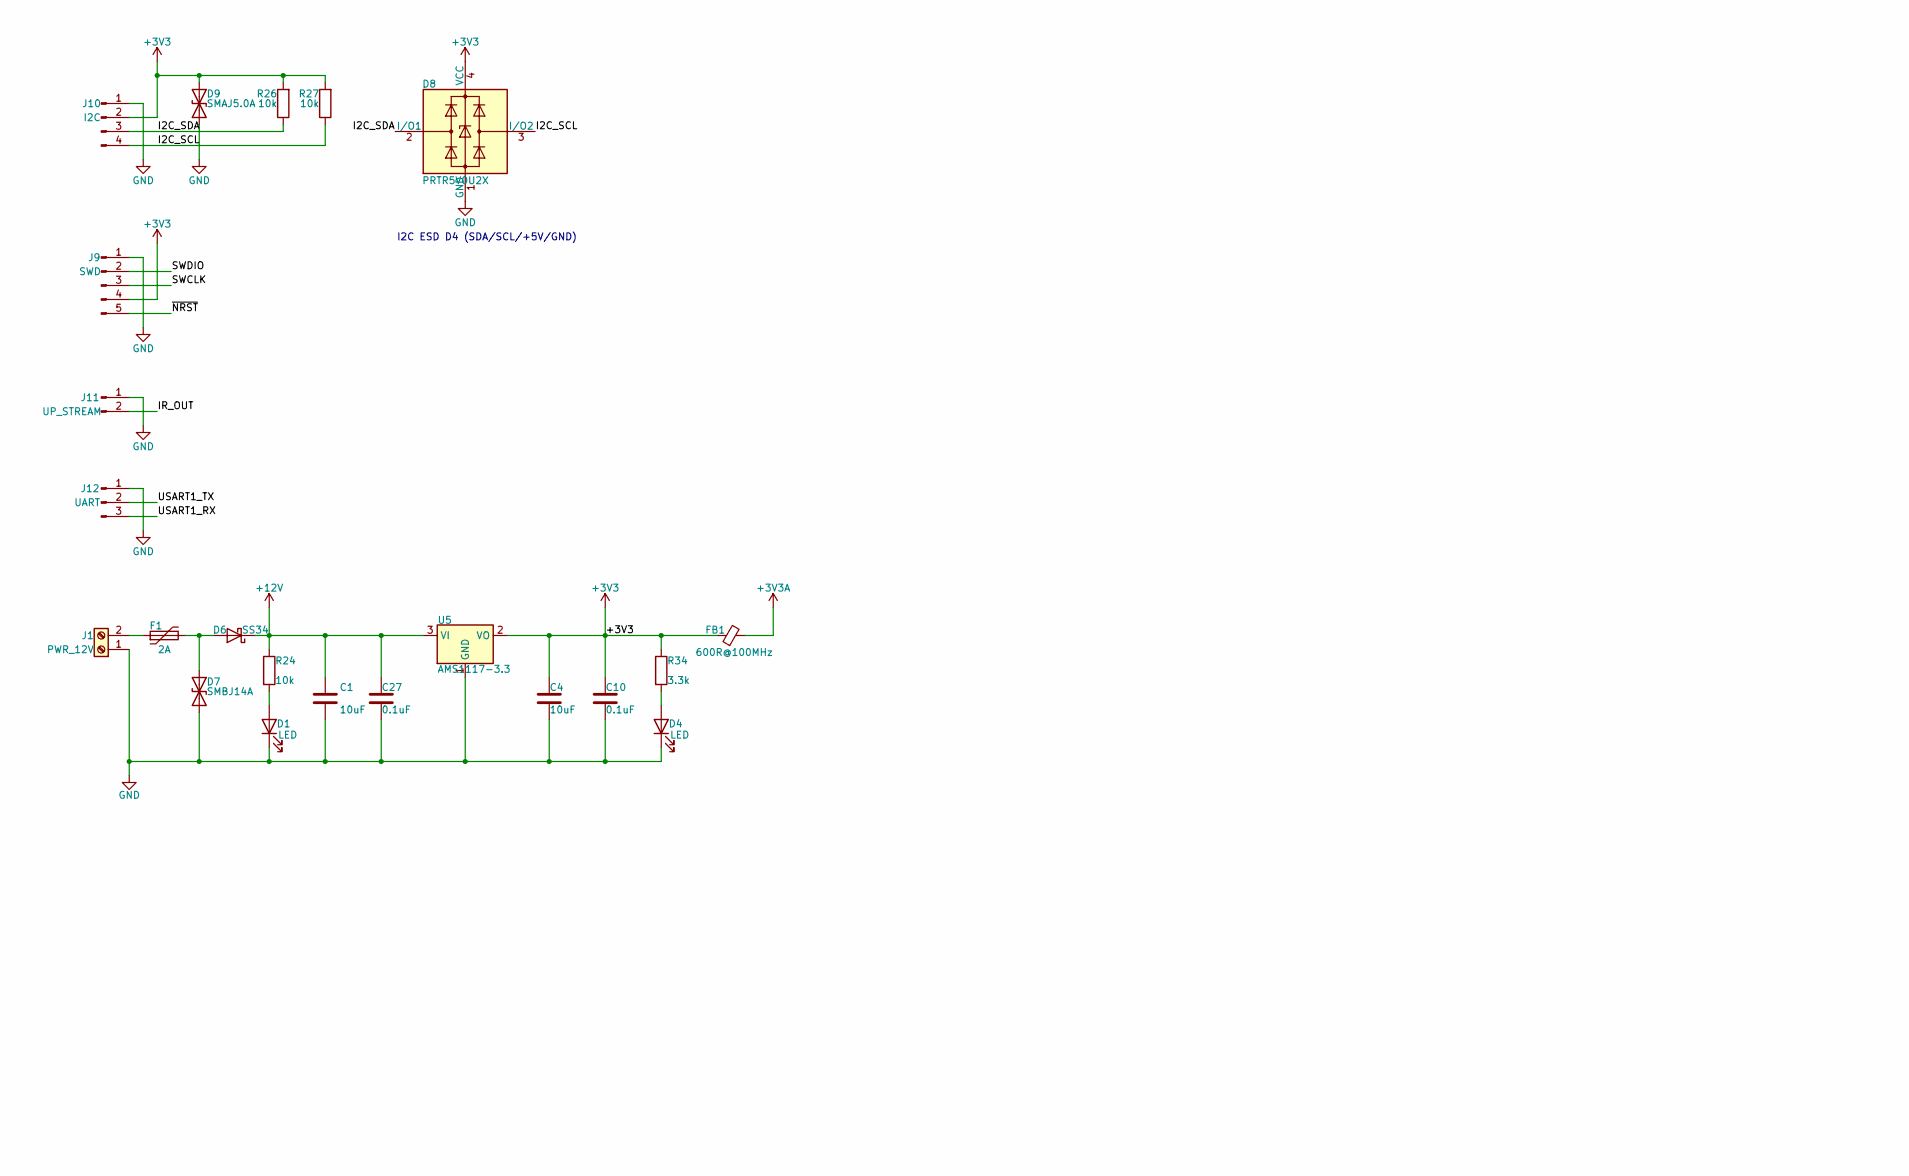
[picture p3: schematic motor-ctrl-mainboard.kicad_sch, part in row 2, column 1]

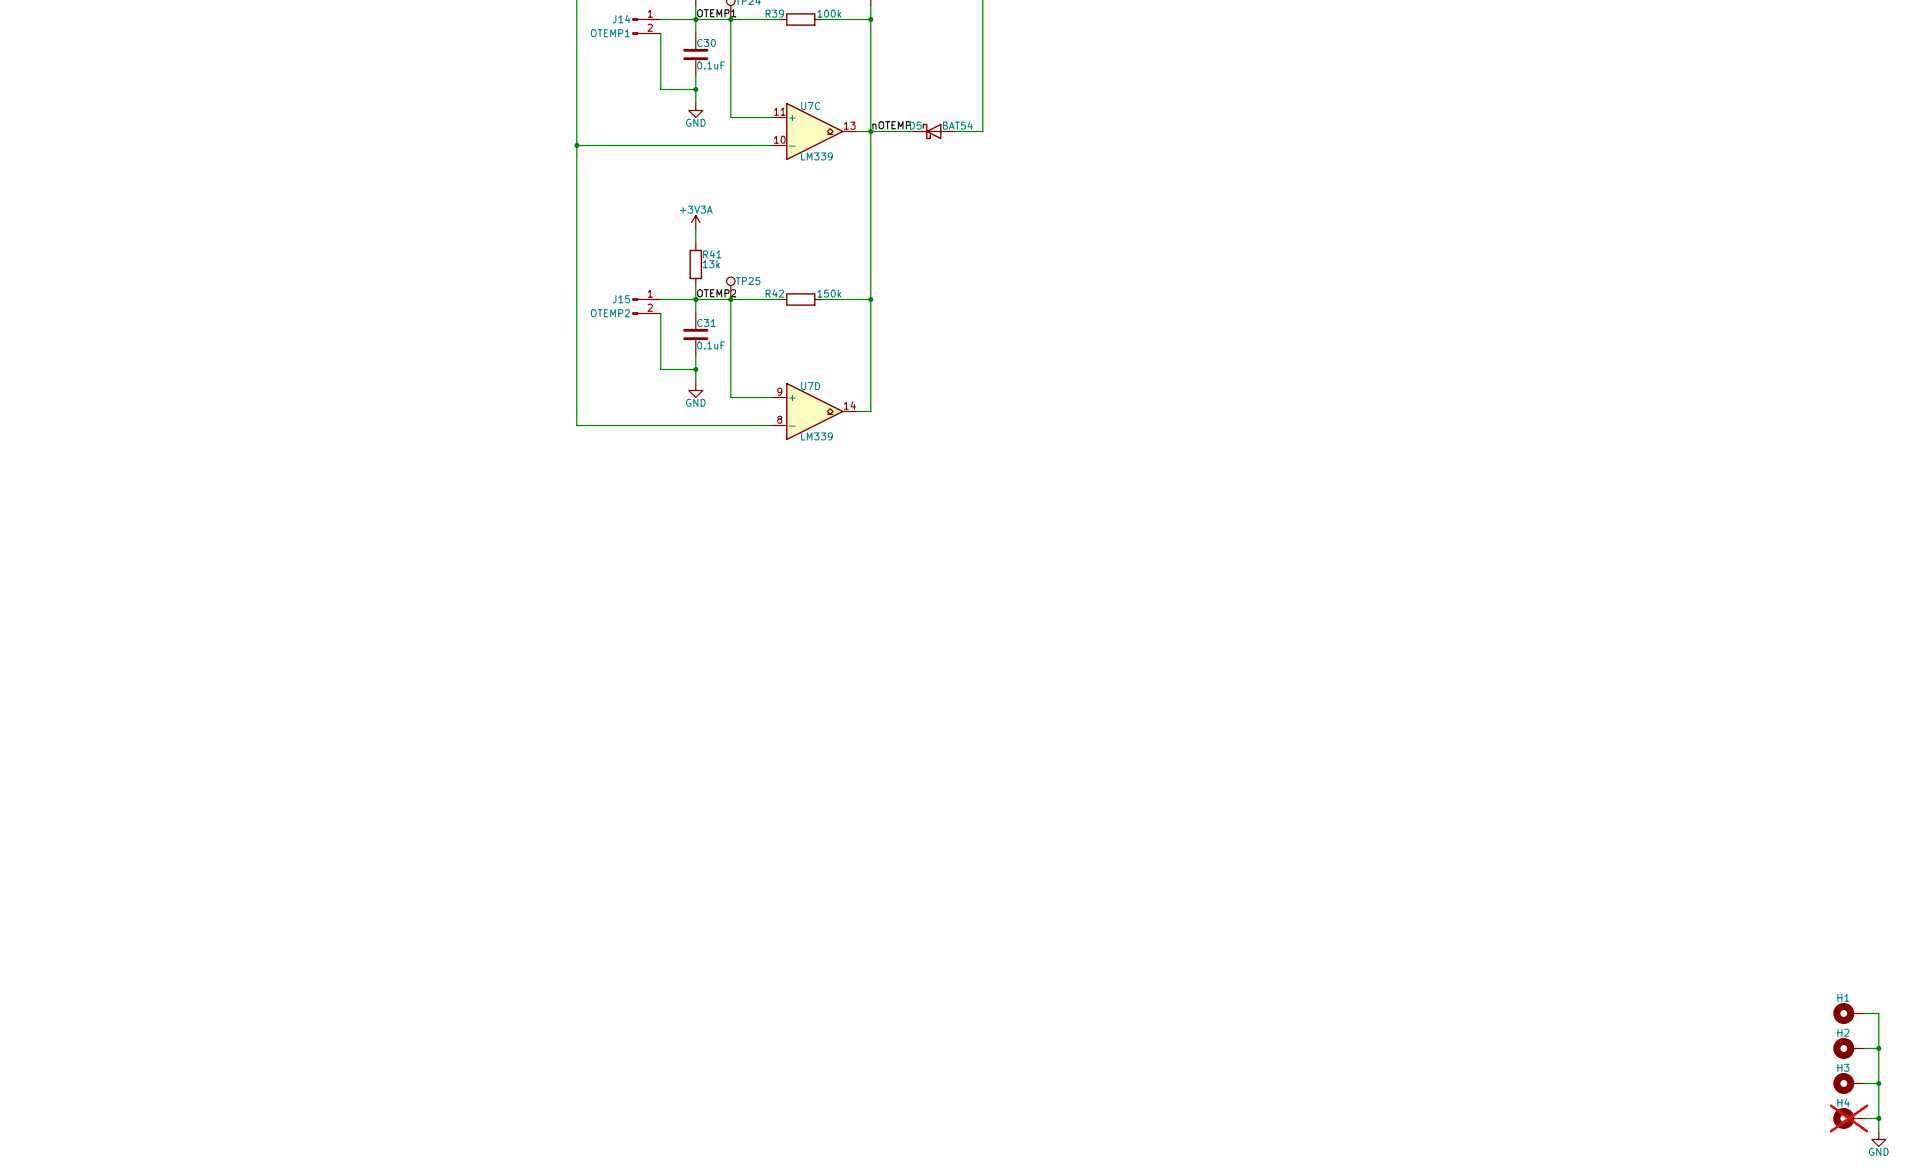
[picture p4: schematic motor-ctrl-mainboard.kicad_sch, part in row 2, column 2]

Parts:
C1, C4, C35, C37, C38: 10uF; C_1206_3216Metric_Pad1.33x1.80mm_HandSolder
C2, C3, C6, C7, C10, C11, C12, C13, C23, C24, C25, C26, C27, C28, C29, C30, C31, C33, C34, C36: 0.1uF; C_0603_1608Metric_Pad1.08x0.95mm_HandSolder
C5: 1uF; C_0603_1608Metric_Pad1.08x0.95mm_HandSolder
C8, C9: 10pF; C_0603_1608Metric_Pad1.08x0.95mm_HandSolder
C14, C15, C16, C17, C18, C19, C20, C21, C22: 1nF; C_0603_1608Metric_Pad1.08x0.95mm_HandSolder
C32: 470nF; C_0805_2012Metric_Pad1.18x1.45mm_HandSolder
D1, D4: LED; LED_0603_1608Metric_Pad1.05x0.95mm_HandSolder
D2, D3: 1N4148; D_SOD-323_HandSoldering
D5: BAT54; D_SOD-323_HandSoldering
D6: SS34; D_SMB_Handsoldering
D7: SMBJ14A; D_SMB_Handsoldering
D8: PRTR5V0U2X; SOT-143
D9: SMAJ5.0A; D_SMA_Handsoldering
F1: 2A; Fuse_1812_4532Metric_Pad1.30x3.40mm_HandSolder
FB1: 600R@100MHz; L_0805_2012Metric_Pad1.05x1.20mm_HandSolder
H1, H2, H3: MountingHole_Pad; MountingHole_3.2mm_M3_ISO14580_Pad
H4: MountingHole_Pad; MountingHole_3.2mm_M3_ISO14580_Pad; not fitted
J1: PWR_12V; TerminalBlock_Phoenix_MKDS-1,5-2-5.08_1x02_P5.08mm_Horizont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
J2: CTRL_U; PinHeader_1x04_P2.54mm_Vertical
J3: CTRL_V; PinHeader_1x04_P2.54mm_Vertical
J4: CTRL_W; PinHeader_1x04_P2.54mm_Vertical
J5: I_SENSE_U; PinSocket_1x02_P2.54mm_Vertical
J6: I_SENSE_V; PinSocket_1x02_P2.54mm_Vertical
J7: I_SENSE_W; PinSocket_1x02_P2.54mm_Vertical
J8: HALL; PinHeader_1x05_P2.54mm_Vertical
J9: SWD; PinHeader_1x05_P2.54mm_Vertical
J10: I2C; PinHeader_1x04_P2.54mm_Vertical
J11: UP_STREAM; PinSocket_1x02_P2.54mm_Vertical
J12: UART; PinSocket_1x03_P2.54mm_Vertical
J14: OTEMP1; PinHeader_1x02_P2.54mm_Vertical
J15: OTEMP2; PinHeader_1x02_P2.54mm_Vertical
J21: PWR_BRIDGE; TerminalBlock_Phoenix_MKDS-1,5-2-5.08_1x02_P5.08mm_Horizont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
JP2: BKIN_EN; SolderJumper-2_P1.3mm_Open_TrianglePad1.0x1.5mm
JP3: BOOT0_SEL; PinHeader_1x02_P2.54mm_Vertical
Q1, Q3: SS8050; SOT-23
Q2: SS8550; SOT-23
R1, R2, R21, R22, R24, R26, R27, R31, R33, R38: 10k; R_0603_1608Metric_Pad0.98x0.95mm_HandSolder
R3, R5, R6, R17, R23, R29: 10R; R_0603_1608Metric_Pad0.98x0.95mm_HandSolder
R4, R13, R14, R15: 1k; R_0603_1608Metric_Pad0.98x0.95mm_HandSolder
R7, R8, R9, R35, R36, R37: 100R; R_0603_1608Metric_Pad0.98x0.95mm_HandSolder
R10, R11, R12, R16, R40: 4.7k; R_0603_1608Metric_Pad0.98x0.95mm_HandSolder
R18, R20: 4.02k; R_0603_1608Metric_Pad0.98x0.95mm_HandSolder
R19: 24.9k; R_0603_1608Metric_Pad0.98x0.95mm_HandSolder
R25: 2.2k; R_0603_1608Metric_Pad0.98x0.95mm_HandSolder
R28: 470R; R_2010_5025Metric_Pad1.40x2.65mm_HandSolder
R30: 39k; R_0603_1608Metric_Pad0.98x0.95mm_HandSolder
R32: 68k; R_0603_1608Metric_Pad0.98x0.95mm_HandSolder
R34: 3.3k; R_0603_1608Metric_Pad0.98x0.95mm_HandSolder
R39: 100k; R_0603_1608Metric_Pad0.98x0.95mm_HandSolder
R41: 13k; R_0603_1608Metric_Pad0.98x0.95mm_HandSolder
R42: 150k; R_0603_1608Metric_Pad0.98x0.95mm_HandSolder
R43, R44: 0R; R_0603_1608Metric_Pad0.98x0.95mm_HandSolder
RT1: 10k NTC; R_0603_1608Metric_Pad0.98x0.95mm_HandSolder
TP1, TP2, TP3, TP4, TP5, TP6, TP7, TP9, TP11, TP12, TP13, TP14, TP15, TP16, TP17, TP18, TP19, TP20, TP21, TP22, TP23, TP24, TP25: TestPoint; TestPoint_Pad_D1.5mm
U1: STM32F030K6Tx; LQFP-32_7x7mm_P0.8mm
U2, U3, U4: INA240A2D; TSSOP-8_4.4x3mm_P0.65mm
U5: AMS1117-3.3; SOT-223-3_TabPin2
U6, U7: LM339; SOIC-14_3.9x8.7mm_P1.27mm
Y1: 8MHz; Crystal_HC18-U_Vertical

Connections:
+3V3: C2.1, C3.1, C4.1, C10.1, D8.4 (VCC), D9.1 (A1), FB1.1, J8.2, J9.4, J10.2, JP3.1 (A), R2.1, R10.1, R11.1, R12.1, R16.1, R22.1, R26.2, R27.2, R34.1, R40.1, RT1.1, U1.1 (VDD), U1.17 (VDD), U5.2 (VO)
+3V3A: C5.1, C6.1, C11.1, C12.1, C13.1, FB1.2, R18.1, R38.1, R41.1, U1.5 (VDDA), U2.5 (VS), U2.6 (REF2), U3.5 (VS), U3.6 (REF2), U4.5 (VS), U4.6 (REF2)
+12V: C1.1, C25.1, C26.1, C27.1, C35.1, C36.1, C37.1, D2.2 (A), D6.1 (K), J21.2, Q1.3 (C), R24.1, R28.1, R30.1, U5.3 (VI), U6.3 (V+), U7.3 (V+)
/BOOT0: JP3.2 (B), R1.1, U1.31 (BOOT0)
/CP_DRIVE: R25.1, TP2.1 (1_1), U1.21 (PA11)
/HALL_A: C20.1, R13.2, TP21.1 (1_1), U1.26 (PB3)
/HALL_A_RAW: J8.3, R10.2, R13.1
/HALL_B: C21.1, R14.2, TP22.1 (1_1), U1.27 (PB4)
/HALL_B_RAW: J8.4, R11.2, R14.1
/HALL_C: C22.1, R15.2, TP23.1 (1_1), U1.28 (PB5)
/HALL_C_RAW: J8.5, R12.2, R15.1
/I2C_SCL: D8.3 (I/O2), J10.4, R27.1, U1.29 (PB6)
/I2C_SDA: D8.2 (I/O1), J10.3, R26.1, U1.30 (PB7)
/IOUT_U: R7.1, TP14.1 (1_1), U2.8 (OUT), U6.4 (-), U6.7 (+)
/IOUT_V: R8.1, TP15.1 (1_1), U3.8 (OUT), U6.9 (+), U6.10 (-)
/IOUT_W: R9.1, TP16.1 (1_1), U4.8 (OUT), U7.4 (-), U7.7 (+)
/IR_OUT: J9.2, J11.2, R36.2
/ISENSE_U: C17.1, R7.2, TP11.1 (1_1), U1.7 (PA1)
/ISENSE_V: C18.1, R8.2, TP12.1 (1_1), U1.8 (PA2)
/ISENSE_W: C19.1, R9.2, TP13.1 (1_1), U1.9 (PA3)
/ITRIP_HI: C23.1, R18.2, R19.1, TP17.1 (1_1), U6.5 (+), U6.11 (+), U7.5 (+)
/ITRIP_LO: C24.1, R19.2, R20.1, TP18.1 (1_1), U6.6 (-), U6.8 (-), U7.6 (-), U7.8 (-), U7.10 (-)
/NTC: C33.1, R21.1, RT1.2, TP20.1 (1_1), U1.6 (PA0)
/OSC_IN: C9.2, U1.2 (PF0), Y1.1
/OSC_OUT: R4.2, U1.3 (PF1)
/OTEMP1: C30.1, J14.1, R38.2, R39.1, TP24.1 (1_1), U7.11 (+)
/OTEMP2: C31.1, J15.1, R41.2, R42.1, TP25.1 (1_1), U7.9 (+)
/PWM_U_H: J2.2, U1.18 (PA8)
/PWM_U_L: J2.1, U1.13 (PA7)
/PWM_V_H: J3.2, U1.19 (PA9)
/PWM_V_L: J3.1, U1.14 (PB0)
/PWM_W_H: J4.2, U1.20 (PA10)
/PWM_W_L: J4.1, U1.15 (PB1)
/SWCLK: J9.3, J12.2, R35.2
/TP_CYCLE: R37.1, TP1.1 (1_1), U1.25 (PA15)
/USART1_RX: J12.3, R37.2
/VSENSE_12V: C28.1, R30.2, R31.1, TP3.1 (1_1), U1.10 (PA4)
/VSENSE_V_BOOST: C29.1, R32.2, R33.1, TP4.1 (1_1), U1.11 (PA5)
/nFAULT: D5.2 (A), JP2.1 (A), R16.2, U6.1, U6.2, U6.13, U6.14, U7.1, U7.2
/nFAULT_MCU: JP2.2 (B), R22.2, TP19.1 (1_1), U1.12 (PA6)
/nOTEMP: D5.1 (K), R39.2, R40.2, R42.2, TP5.1 (1_1), U1.22 (PA12), U7.13, U7.14
/~NRST: C7.1, J9.5, R2.2, U1.4 (NRST)
GND: C1.2, C2.2, C3.2, C4.2, C5.2, C6.2, C7.2, C8.1, C9.1, C10.2, C11.2, C12.2, C13.2, C17.2, C18.2, C19.2, C20.2, C21.2, C22.2, C23.2, C24.2, C25.2, C26.2, C27.2, C28.2, C29.2, C30.2, C31.2, C33.2, C34.2, C35.2, C36.2, C37.2, C38.2, D1.1 (K), D4.1 (K), D7.2 (A2), D8.1 (GND), D9.2 (A2), H1.1 (1_1), H2.1 (1_1), H3.1 (1_1), H4.1, J1.1, J2.3, J3.3, J4.3, J8.1, J9.1, J10.1, J11.1, J12.1, J14.2, J15.2, J21.1, Q2.3 (C), Q3.2 (E), R1.2, R20.2, R21.2, R31.2, R33.2, U1.16 (VSS), U1.32 (VSS), U2.1 (NC), U2.4 (GND), U2.7 (REF1), U3.1 (NC), U3.4 (GND), U3.7 (REF1), U4.1 (NC), U4.4 (GND), U4.7 (REF1), U5.1 (GND), U6.12 (V-), U7.12 (V-)
unnamed: C8.2, R4.1, Y1.2
unnamed: D1.2 (A), R24.2
unnamed: C32.1, D2.1 (K), D3.2 (A), TP9.1 (1_1)
unnamed: D4.2 (A), R34.2
unnamed: D6.2 (A), D7.1 (A1), F1.2
unnamed: F1.1, J1.2
unnamed: J5.1, R23.1
unnamed: J5.2, R17.1
unnamed: J6.1, R29.1
unnamed: J6.2, R3.1
unnamed: J7.1, R6.1
unnamed: J7.2, R5.1
unnamed: Q1.1 (B), R43.2
unnamed: C32.2, Q1.2 (E), Q2.2 (E), TP7.1 (1_1)
unnamed: Q2.1 (B), R44.2
unnamed: Q3.1 (B), R25.2
unnamed: Q3.3 (C), R28.2, R43.1, R44.1, TP6.1 (1_1)
unnamed: R36.1, U1.23 (PA13)
unnamed: R35.1, U1.24 (PA14)
unnamed: C14.1, R17.2, U2.2 (IN+)
unnamed: C14.2, R23.2, U2.3 (IN-)
unnamed: C15.1, R3.2, U3.2 (IN+)
unnamed: C15.2, R29.2, U3.3 (IN-)
unnamed: C16.1, R5.2, U4.2 (IN+)
unnamed: C16.2, R6.2, U4.3 (IN-)
V_BOOST: C34.1, C38.1, D3.1 (K), J2.4, J3.4, J4.4, R32.1

Notes on the sheet:
ADC_IN3
实际贴装3.9k
断开，SWD（从 Flash 启动） 闭合，RUN（从 bootloader 启动）
TIM3_CH2
TIM3_CH1
ADC_IN5
TIM1_CH3
TIM1_CH1
ADC_IN0
TIM1_CH4
实际贴装24k
I2C ESD D4 (SDA/SCL/+5V/GND)
TIM1_CH2N
TIM1_CH3N
ADC_IN1
TIM1_BKIN
TIM1_ETR
TIM1_CH1N
ADC_IN4
TIM1_CH2
ADC_IN2

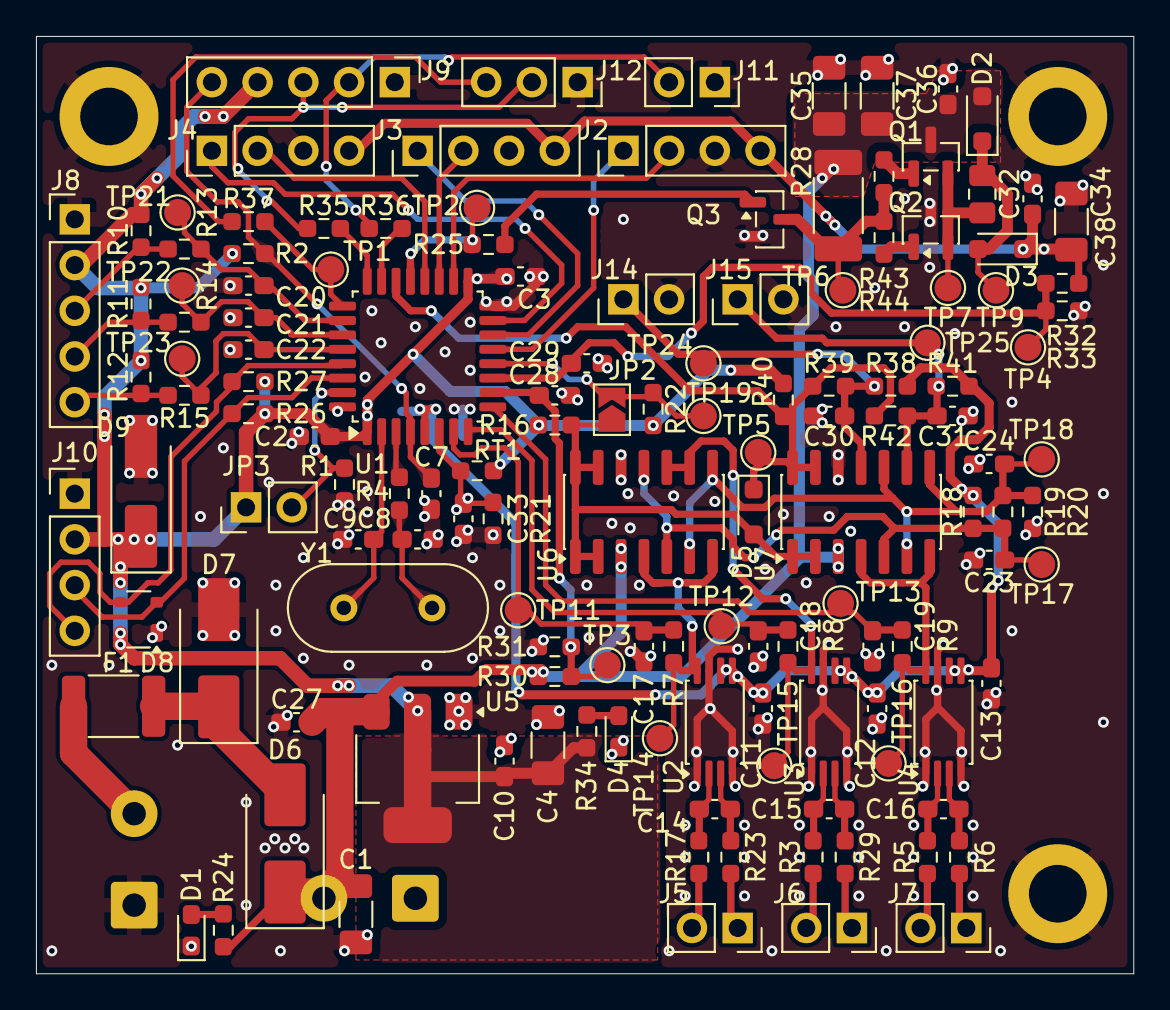
[picture p5: board motor-ctrl-mainboard.kicad_pcb from above]

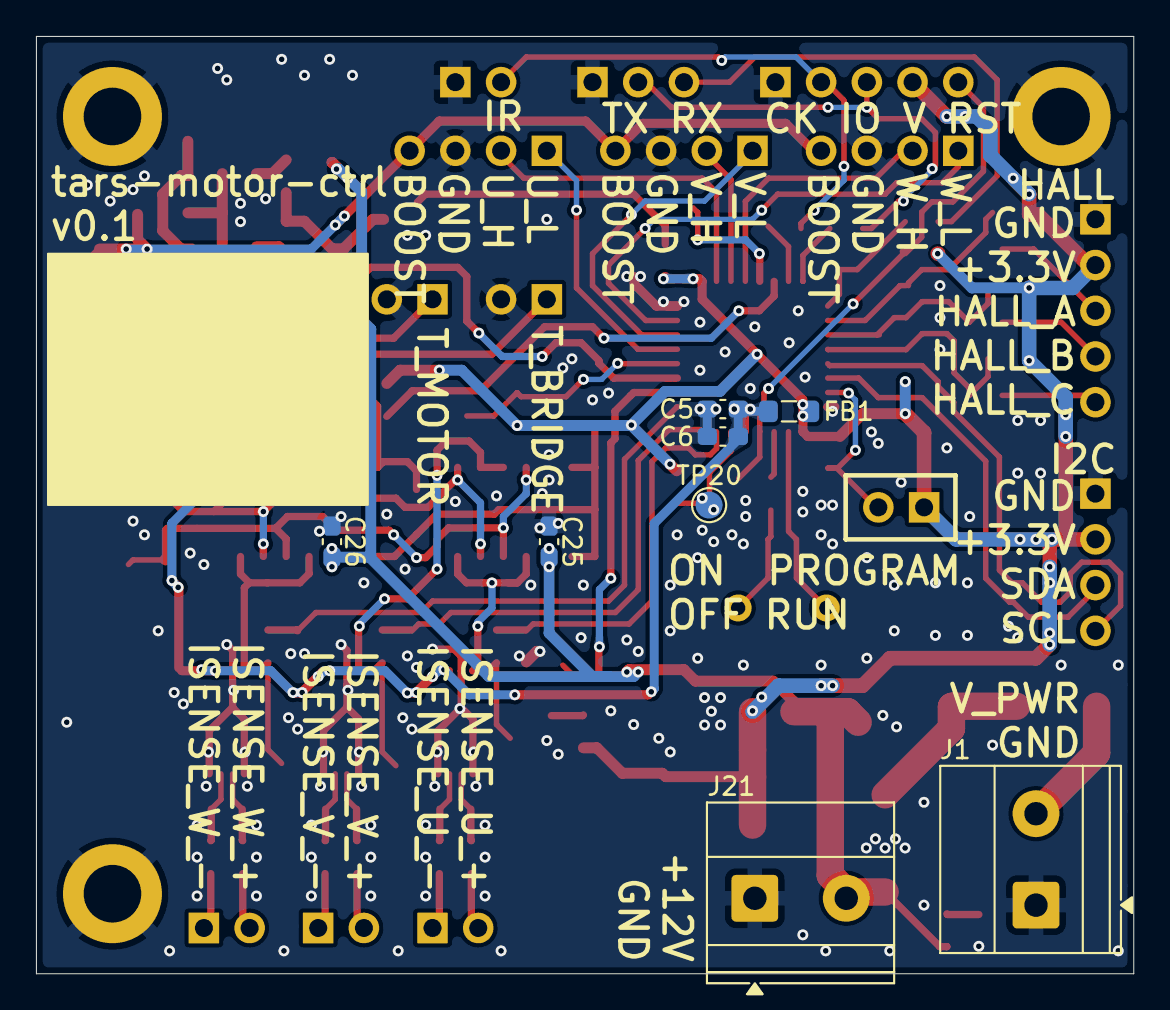
[picture p6: board motor-ctrl-mainboard.kicad_pcb from below]

Board: 2 copper layers, 61.0 x 52.1 mm, 148 parts (8 on the bottom side), 69 nets.
