zhang1career/tars-motor-ctrl/src/platforms/stm32f030/motor_adc.c

#include "motor_adc.h"
#include "motor_pwm.h"
#include "motor_tick.h"
#include "boost.h"
#include "board_pins.h"
#include "main.h"
#include "reset_diag.h"

volatile uint16_t g_motor_adc_raw[MOTOR_ADC_CH_COUNT];

static ADC_HandleTypeDef s_hadc;
static DMA_HandleTypeDef s_hdma;
static uint8_t s_ready;
static uint16_t s_ntc_raw;
static uint16_t s_vboost_raw;
static uint16_t s_v12_mv;

static uint16_t adc_sw_one(ADC_HandleTypeDef *hadc, uint32_t channel)
{
  ADC_ChannelConfTypeDef ch = {0};
  uint16_t v = 0U;

  ADC1->CHSELR = 0U;
  ch.Channel = channel;
  ch.Rank = ADC_RANK_CHANNEL_NUMBER;
  (void)HAL_ADC_ConfigChannel(hadc, &ch);
  if (HAL_ADC_Start(hadc) == HAL_OK)
  {
    if (HAL_ADC_PollForConversion(hadc, 10U) == HAL_OK)
    {
      v = (uint16_t)HAL_ADC_GetValue(hadc);
    }
    (void)HAL_ADC_Stop(hadc);
  }
  ch.Rank = ADC_RANK_NONE;
  (void)HAL_ADC_ConfigChannel(hadc, &ch);
  return v;
}

uint16_t MotorAdc_NtcRaw(void)
{
  return s_ntc_raw;
}

uint16_t MotorAdc_VboostRaw(void)
{
  return s_vboost_raw;
}

void MotorAdc_NotifyVboostSample(uint16_t raw)
{
  s_vboost_raw = raw;
}

int MotorAdc_BootstrapVboost(void)
{
  uint16_t v;

  if (s_ready == 0U)
  {
    return 0;
  }
  (void)HAL_ADC_Stop_DMA(&s_hadc);
  v = adc_sw_one(&s_hadc, BOARD_ADC_VBOOST_CH);
  (void)MotorAdc_Start();
  MotorAdc_NotifyVboostSample(v);
  return (v >= 800U) ? 1 : 0;
}

uint16_t MotorAdc_VbusRailMv(void)
{
  return s_v12_mv;
}

static void motor_adc_pins_init(void)
{
  GPIO_InitTypeDef gpio = {0};

  __HAL_RCC_GPIOA_CLK_ENABLE();
  gpio.Pin = GPIO_PIN_0 | GPIO_PIN_1 | GPIO_PIN_2 | GPIO_PIN_3 | GPIO_PIN_4 |
             GPIO_PIN_5;
  gpio.Mode = GPIO_MODE_ANALOG;
  gpio.Pull = GPIO_NOPULL;
  HAL_GPIO_Init(GPIOA, &gpio);
}

/* TIM1 CH4 is the boost switch, so it cannot also be the ADC lead pulse.
 * Center-aligned TIM1 counts 0..ARR and back. One PWM period is 2*ARR
 * clocks (2398 when ARR is 1199), not 2*(ARR+1). TIM3 must use that same
 * count: 2400 walks two clocks per cycle and the sample lands on the
 * switching edge. OC1REF rises MOTOR_ADC_LEAD_COUNTS before the TIM1 peak
 * when both counters leave 0 together. CC1E stays off, so PB4/PB5 are
 * not driven. */
static void motor_adc_trigger_init(void)
{
  uint32_t arr = __HAL_TIM_GET_AUTORELOAD(&htim1);
  uint32_t period;
  uint32_t ccr;

  if (arr <= MOTOR_ADC_LEAD_COUNTS)
  {
    arr = MOTOR_ADC_LEAD_COUNTS + 1U;
  }
  period = arr * 2U;
  ccr = arr - MOTOR_ADC_LEAD_COUNTS;

  __HAL_RCC_TIM3_CLK_ENABLE();
  TIM3->CR1 = 0U;
  TIM3->PSC = 0U;
  TIM3->ARR = period - 1U;
  TIM3->CCR1 = ccr;
  TIM3->CCMR1 = (7U << TIM_CCMR1_OC1M_Pos);
  TIM3->CCER = 0U;
  TIM3->CR2 = (4U << TIM_CR2_MMS_Pos);
  TIM3->EGR = TIM_EGR_UG;
  TIM3->SR = 0U;
}

void MotorAdc_Init(void)
{
  ADC_ChannelConfTypeDef ch = {0};

  if (s_ready != 0U)
  {
    return;
  }

  motor_adc_pins_init();
  motor_adc_trigger_init();

  __HAL_RCC_DMA1_CLK_ENABLE();
  s_hdma.Instance = DMA1_Channel1;
  s_hdma.Init.Direction = DMA_PERIPH_TO_MEMORY;
  s_hdma.Init.PeriphInc = DMA_PINC_DISABLE;
  s_hdma.Init.MemInc = DMA_MINC_ENABLE;
  s_hdma.Init.PeriphDataAlignment = DMA_PDATAALIGN_HALFWORD;
  s_hdma.Init.MemDataAlignment = DMA_MDATAALIGN_HALFWORD;
  s_hdma.Init.Mode = DMA_CIRCULAR;
  s_hdma.Init.Priority = DMA_PRIORITY_HIGH;
  if (HAL_DMA_Init(&s_hdma) != HAL_OK)
  {
    Error_Handler();
  }

  __HAL_RCC_ADC1_CLK_ENABLE();
  s_hadc.Instance = ADC1;
  /* PCLK/4 = 12 MHz. PCLK/2 would be 24 MHz and the F030 ADC is specified to
   * 14 MHz. Synchronous to PCLK, so no HSI14 jitter against the timer. */
  s_hadc.Init.ClockPrescaler = ADC_CLOCK_SYNC_PCLK_DIV4;
  s_hadc.Init.Resolution = ADC_RESOLUTION_12B;
  s_hadc.Init.DataAlign = ADC_DATAALIGN_RIGHT;
  s_hadc.Init.ScanConvMode = ADC_SCAN_DIRECTION_FORWARD;
  s_hadc.Init.EOCSelection = ADC_EOC_SINGLE_CONV;
  s_hadc.Init.LowPowerAutoWait = DISABLE;
  s_hadc.Init.LowPowerAutoPowerOff = DISABLE;
  s_hadc.Init.ContinuousConvMode = DISABLE;
  s_hadc.Init.DiscontinuousConvMode = DISABLE;
  s_hadc.Init.ExternalTrigConv = ADC_EXTERNALTRIGCONV_T3_TRGO;
  s_hadc.Init.ExternalTrigConvEdge = ADC_EXTERNALTRIGCONVEDGE_RISING;
  s_hadc.Init.DMAContinuousRequests = ENABLE;
  /* Overwrite rather than stall: one lost conversion must not wedge the chain
   * that the current loop depends on. A shifted channel mapping is detectable
   * because VBUS reads ~3240 at 24 V while the current channels sit near 2048. */
  s_hadc.Init.Overrun = ADC_OVR_DATA_OVERWRITTEN;
  s_hadc.Init.SamplingTimeCommon = ADC_SAMPLETIME_7CYCLES_5;

  __HAL_LINKDMA(&s_hadc, DMA_Handle, s_hdma);

  if (HAL_ADC_Init(&s_hadc) != HAL_OK)
  {
    Error_Handler();
  }

  ch.Channel = BOARD_ADC_IU_CH;
  ch.Rank = ADC_RANK_CHANNEL_NUMBER;
  if (HAL_ADC_ConfigChannel(&s_hadc, &ch) != HAL_OK)
  {
    Error_Handler();
  }
  ch.Channel = BOARD_ADC_IV_CH;
  (void)HAL_ADC_ConfigChannel(&s_hadc, &ch);
  ch.Channel = BOARD_ADC_IW_CH;
  (void)HAL_ADC_ConfigChannel(&s_hadc, &ch);
  /* Kept in the scan so IU/IV/IW stay on the same timetable. With
   * MOTOR_VBUS_SENSE=0 the code is not motor vdc; see MotorAdc_VbusMv. */
  ch.Channel = BOARD_ADC_VBUS_CH;
  (void)HAL_ADC_ConfigChannel(&s_hadc, &ch);
  ch.Channel = BOARD_ADC_VBOOST_CH;
  (void)HAL_ADC_ConfigChannel(&s_hadc, &ch);

  if (HAL_ADCEx_Calibration_Start(&s_hadc) != HAL_OK)
  {
    Error_Handler();
  }

#if defined(MOTOR_ADC_STROBE) && (MOTOR_ADC_STROBE != 0)
  {
    GPIO_InitTypeDef gpio = {0};

    gpio.Pin = BOARD_TP_CYCLE_PIN;
    gpio.Mode = GPIO_MODE_OUTPUT_PP;
    gpio.Pull = GPIO_NOPULL;
    gpio.Speed = GPIO_SPEED_FREQ_HIGH;
    HAL_GPIO_Init(BOARD_TP_CYCLE_PORT, &gpio);
    HAL_GPIO_WritePin(BOARD_TP_CYCLE_PORT, BOARD_TP_CYCLE_PIN, GPIO_PIN_RESET);
  }
#endif

  /* Below I2C (prio 0): a same-priority tick starves the TNB slave. */
  HAL_NVIC_SetPriority(DMA1_Channel1_IRQn, 1, 0);
  HAL_NVIC_EnableIRQ(DMA1_Channel1_IRQn);

  s_ready = 1U;
}

void MotorAdc_EnableTick(void)
{
  DMA1->IFCR = DMA_IFCR_CTCIF1 | DMA_IFCR_CHTIF1 | DMA_IFCR_CTEIF1;
  DMA1_Channel1->CCR &= ~DMA_CCR_HTIE;
  DMA1_Channel1->CCR |= DMA_CCR_TCIE;
}

void MotorAdc_DisableTick(void)
{
  DMA1_Channel1->CCR &= ~DMA_CCR_TCIE;
}

#define MOTOR_TICK_CYC_TARGET 1000U
#define MOTOR_TICK_CYC_STEADY 1200U
#define MOTOR_TICK_CYC_HARD   2400U

void MotorAdc_DmaIrq(void)
{
  uint32_t isr = DMA1->ISR;

  if ((isr & DMA_ISR_TCIF1) != 0U)
  {
    uint32_t load;
    uint32_t a;
    uint32_t b;
    uint32_t cyc;

    DMA1->IFCR = DMA_IFCR_CTCIF1;
    MotorAdc_NotifyVboostSample(g_motor_adc_raw[MOTOR_ADC_VBOOST]);
#if defined(MOTOR_ADC_STROBE) && (MOTOR_ADC_STROBE != 0)
    /* Pulse first: it marks sample end, and the edges must not sit in the
     * next sequence (measurement-validity 3.9). */
    BOARD_TP_CYCLE_PORT->BSRR = BOARD_TP_CYCLE_PIN;
    {
      volatile uint32_t n;
      for (n = 0U; n < 4U; n++)
      {
      }
    }
    BOARD_TP_CYCLE_PORT->BRR = BOARD_TP_CYCLE_PIN;
#endif
    load = SysTick->LOAD;
    a = SysTick->VAL;
    MotorTick_OnAdcComplete();
    b = SysTick->VAL;
    /* This window is the whole tick. Target is MOTOR_TICK_CYC_TARGET.
     * Steady ticks should stay at or under MOTOR_TICK_CYC_STEADY.
     * MOTOR_TICK_CYC_HARD is the 50 us ceiling already counted by the next TC flag. */
    cyc = (a >= b) ? (a - b) : (a + load + 1U - b);
    if (cyc > g_reset_diag[RESET_DIAG_TICK_CYC_MAX])
    {
      g_reset_diag[RESET_DIAG_TICK_CYC_MAX] = cyc;
    }
    g_reset_diag[RESET_DIAG_TICK_CYC_SUM] += cyc;
    g_reset_diag[RESET_DIAG_TICK_TOTAL] += 1U;
    if ((DMA1->ISR & DMA_ISR_TCIF1) != 0U)
    {
      g_reset_diag[RESET_DIAG_TICK_OVERRUN] += 1U;
    }
  }
  if ((isr & DMA_ISR_HTIF1) != 0U)
  {
    DMA1->IFCR = DMA_IFCR_CHTIF1;
  }
  if ((isr & DMA_ISR_TEIF1) != 0U)
  {
    DMA1->IFCR = DMA_IFCR_CTEIF1;
  }
}

int MotorAdc_Start(void)
{
  if (s_ready == 0U)
  {
    MotorAdc_Init();
  }

  if (HAL_ADC_Start_DMA(&s_hadc, (uint32_t *)(void *)g_motor_adc_raw,
                        MOTOR_ADC_CH_COUNT) != HAL_OK)
  {
    return 0;
  }
  /* HAL_DMA_Start_IT also arms HT; one sequence must make one tick. TCIE
   * stays off until MotorTick_Start so init does not run the controller. */
  DMA1_Channel1->CCR &= ~(DMA_CCR_HTIE | DMA_CCR_TCIE);
  /* TIM3 TRGO is the sample edge. CH1–3 and the boost pin stay off here. */
  Boost_Resync();
  return 1;
}

void MotorAdc_Stop(void)
{
  if (s_ready != 0U)
  {
    (void)HAL_ADC_Stop_DMA(&s_hadc);
  }
}

static void motor_adc_foc_channels(void)
{
  ADC_ChannelConfTypeDef ch = {0};

  ADC1->CHSELR = 0U;
  ch.Rank = ADC_RANK_CHANNEL_NUMBER;
  ch.Channel = BOARD_ADC_IU_CH;
  (void)HAL_ADC_ConfigChannel(&s_hadc, &ch);
  ch.Channel = BOARD_ADC_IV_CH;
  (void)HAL_ADC_ConfigChannel(&s_hadc, &ch);
  ch.Channel = BOARD_ADC_IW_CH;
  (void)HAL_ADC_ConfigChannel(&s_hadc, &ch);
  ch.Channel = BOARD_ADC_VBUS_CH;
  (void)HAL_ADC_ConfigChannel(&s_hadc, &ch);
  ch.Channel = BOARD_ADC_VBOOST_CH;
  (void)HAL_ADC_ConfigChannel(&s_hadc, &ch);
}

int MotorAdc_PollRails(uint16_t *vref_now, uint16_t *ts_raw)
{
  uint16_t vr = 0U;
  uint16_t ts = 0U;
  uint8_t tick_on;

  if (s_ready == 0U)
  {
    return 0;
  }

  tick_on = ((DMA1_Channel1->CCR & DMA_CCR_TCIE) != 0U) ? 1U : 0U;
  MotorAdc_DisableTick();
  (void)HAL_ADC_Stop_DMA(&s_hadc);

  ADC->CCR |= ADC_CCR_VREFEN | ADC_CCR_TSEN;
  HAL_Delay(1);

  ADC1->CHSELR = 0U;
  s_hadc.Init.ExternalTrigConv = ADC_SOFTWARE_START;
  s_hadc.Init.ExternalTrigConvEdge = ADC_EXTERNALTRIGCONVEDGE_NONE;
  s_hadc.Init.DMAContinuousRequests = DISABLE;
  s_hadc.Init.SamplingTimeCommon = ADC_SAMPLETIME_239CYCLES_5;
  if (HAL_ADC_Init(&s_hadc) != HAL_OK)
  {
    goto restore;
  }

  vr = adc_sw_one(&s_hadc, ADC_CHANNEL_VREFINT);
  ts = adc_sw_one(&s_hadc, ADC_CHANNEL_TEMPSENSOR);
  s_ntc_raw = adc_sw_one(&s_hadc, BOARD_ADC_NTC_CH);
  s_vboost_raw = adc_sw_one(&s_hadc, BOARD_ADC_VBOOST_CH);
  {
    uint32_t mv = ((uint32_t)adc_sw_one(&s_hadc, BOARD_ADC_VBUS_CH) *
                   (uint32_t)MOTOR_VBUS_MV_MUL) >> 10;

    if (mv > 65535U)
    {
      mv = 65535U;
    }
    s_v12_mv = (uint16_t)mv;
  }

  if (vref_now != 0)
  {
    *vref_now = vr;
  }
  if (ts_raw != 0)
  {
    *ts_raw = ts;
  }

restore:
  ADC->CCR &= ~(ADC_CCR_VREFEN | ADC_CCR_TSEN);
  ADC1->CHSELR = 0U;
  s_hadc.Init.ExternalTrigConv = ADC_EXTERNALTRIGCONV_T3_TRGO;
  s_hadc.Init.ExternalTrigConvEdge = ADC_EXTERNALTRIGCONVEDGE_RISING;
  s_hadc.Init.DMAContinuousRequests = ENABLE;
  s_hadc.Init.SamplingTimeCommon = ADC_SAMPLETIME_7CYCLES_5;
  (void)HAL_ADC_Init(&s_hadc);
  motor_adc_foc_channels();
  (void)MotorAdc_Start();
  if (tick_on != 0U)
  {
    MotorAdc_EnableTick();
  }
  return ((vr != 0U) && (ts != 0U)) ? 1 : 0;
}

void HAL_ADC_MspInit(ADC_HandleTypeDef *hadc)
{
  if (hadc->Instance == ADC1)
  {
    __HAL_RCC_ADC1_CLK_ENABLE();
  }
}
