zhang1career/tars-motor-ctrl/src/platforms/stm32f030/motor_cycles.h

#ifndef MOTOR_CYCLES_H
#define MOTOR_CYCLES_H

#include <stdint.h>
#include "stm32f0xx_hal.h"

/*
 * Cortex-M0 has no DWT cycle counter, so a free-running 16-bit timer stands in.
 * TIM16 rather than TIM3: TIM3_CH1/CH2 are the only capture channels reachable
 * from HALL_B (PB4) and HALL_C (PB5) on LQFP-32, so TIM3 is kept free for rotor
 * angle work (mainboard-spec.md section 3.1).
 */
#define MOTOR_CYCLES_TIM TIM16

/* Prescaler 0 -> 48 MHz on STM32F030 @ 48 MHz SYSCLK. */
#define MOTOR_CYCLES_HZ 48000000U

void MotorCycles_Init(void);
uint16_t MotorCycles_Read(void);
uint16_t MotorCycles_Delta(uint16_t start, uint16_t end);

/* Median of eight back-to-back read pairs (measurement overhead). */
uint16_t MotorCycles_Overhead(void);

/* Measure fn(); subtract overhead; IRQs disabled for the timed region. */
uint16_t MotorCycles_Measure(void (*fn)(void));

/*
 * Same as MotorCycles_Measure(), but drives PA15 high for the timed region
 * so a scope can cross-check pulse width against cycle count / 48 MHz.
 */
uint16_t MotorCycles_MeasureScope(void (*fn)(void));

#endif /* MOTOR_CYCLES_H */
