zhang1career/tars-motor-ctrl/src/shared/tnb/tnb_crc.h

#ifndef TNB_CRC_H
#define TNB_CRC_H

#include <stdint.h>

#ifdef __cplusplus
extern "C" {
#endif

uint8_t TnbCrc_Byte(uint8_t crc, uint8_t data);
uint8_t TnbCrc_Buf(uint8_t crc, const uint8_t *buf, uint32_t len);

#ifdef __cplusplus
}
#endif

#endif /* TNB_CRC_H */
