zhang1career/tars-motor-ctrl/(commit log)

2026-10-14 12V V_PWR works
2026-10-15 pcb saved before boost designing
2026-10-20 Pause boost milestone: PA5 charge-pump loop on PWM-synchronized ADC.
    Closed-loop V_BOOST uses PA5 in the motor DMA scan, Boost_Poll filtering,
    wide LO/HI band, 43 ms step limit, and 16:1 logical duty mapped to CCR4
    0..8. Spec §9.5.5 and boost_idle_watch.sh document bench expectations;
    ~1.5 s idle swing remains for later (dither reverted).
2026-10-21 Remove dead s_run_req boost gate and fix boost probe script.
    Mot start always goes through RequestRun; the run_req wait loop was unreachable. mot_start_probe derives Boost_Ready from g_boost.adc like the firmware.
